dangdangduong2k2/Graduation_project/3d/images/electronics_case.png

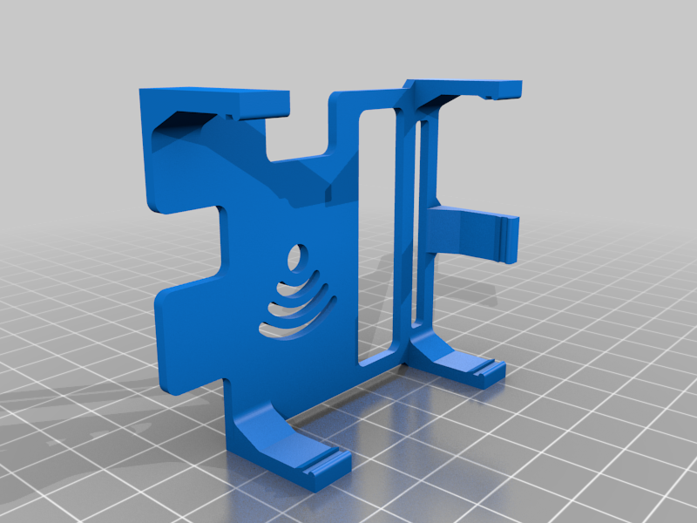
3d/images/electronics_case.png
