dangdangduong2k2/Graduation_project/3d/images/Modifiying-your-PyBot-Robotic-Arm.jpg

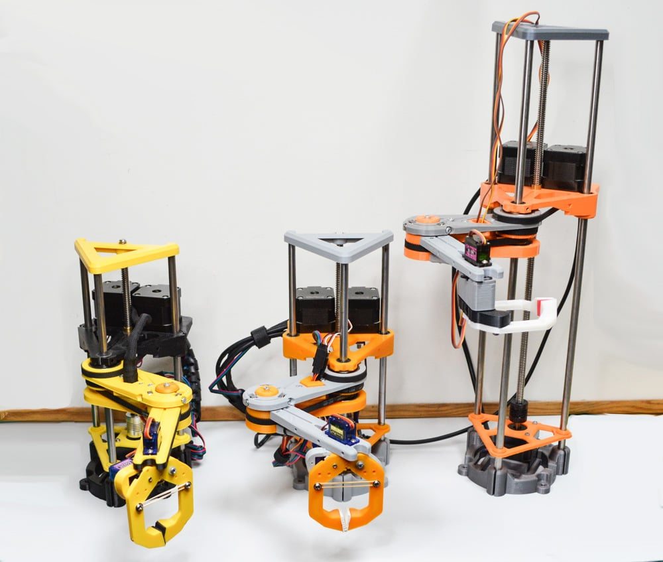
3d/images/Modifiying-your-PyBot-Robotic-Arm.jpg
