dangdangduong2k2/Graduation_project/3d/README.txt

Arduino Robotic Arm (OPEN SOURCE) + Python control APP + EXTRAS by jjrobots on Thingiverse: https://www.thingiverse.com/thing:4579405
