dangdangduong2k2/Graduation_project/0.HardWare_Unit/0.PCB/1.main/GiaCong/BOM/2024-12-17 BOM gpr.xlsx

Code | Code_sub1 | Comment | Description | Designator | LibRef | Layer | Footprint | SMT | Quantity | Price | LCSC Part | Reference Link | Erase IC | Note
 |  | DRV8825 |  | U2, U3, U5 | DRV8825 | Top | DRV8825 |  | 3
 |  | STM32F103C8T6 |  | U4 | STM32F103C8T6 | Top | LQFP-48_L7.0-W7.0-P0.50-LS9.0-BL |  | 1
 |  | XT60PW-M |  | CN1 | XT60PW-M | Top | CONN-TH_XT60PW-M |  | 1
1024-078 |  | 470R | Resistor SMD 0805 | R4, R7, R14 | Res 470R 0805 | Top | RES-SMD-0805 |  | 3
1024-094 |  | 2.2k | Resistor SMD 0805 | R1, R23, R26 | Res 2.2K 0805 | Top | RES-SMD-0805 |  | 3
1024-103 |  | 4.7K | Resistor SMD 0805 | R10, R11, R15, R21, R22, R25 | Res 4.7k 0805 | Top | RES-SMD-0805 |  | 6
1024-111 |  | 10K | Resistor SMD 0805 | R2, R5, R6, R8, R9, R16, R17, R29, R30, R31 | Res 10k 0805 | Top | RES-SMD-0805 |  | 10
1402-225 |  | 100uF/35V | Polarized Capacitor (Axial) 100uF 35V | C5, C11 | Cap Pol 100uF/35V | Top | C_6.3x12 |  | 2
1402-228 |  | 220uF/35V | Polarized Capacitor (Axial) 220uF 35V | C3 | Cap Pol 220uF/35V | Top | C8X12mm |  | 1
1436-100 |  | 10uF/25V | Cap SMD 0805 10uF | C8, C9 | Cap 0805 10uF 25V | Top | C_0805_SMD |  | 2
1438-080 |  | 104 | Cap SMD 0805 104-100nF-0.1uF 50V | C2, C4, C6, C7, C12, C14, C18, C19, C20, C21 | Cap 0805 104 100nF | Top | C_0805_SMD |  | 10
1522-003 |  | 68uH | CDRH127 Cuộn Cảm Dán SMD 1280-680 68uH 3.2A | L1 | IND CDRH127 1280-680 68uH | Top | CDRH127 |  | 1
2005-008 |  | SS34 | Surface-Mount Schottky Barrier Rectifier | D1, D2, D3, D5 | SS34-SMA | Top | D_SMA |  | 4
3504-028 * 0.1 |  | HDR-M-4P | HDR 2.54 MALE | P3 | HDR 2.54 M 4 Pin | Top | HDR_M_1X4 |  | 1
3509-010 |  | XH2.54 2P | XH2.54 RA | P8, P9, P10 | XH2.54_2P_RA | Top | XH2.54_2P_RA |  | 3
3509-011 |  | XH2.54 3P | XH2.54 RA | P11 | XH2.54_3P_RA | Top | XH2.54_3P_RA |  | 1
3509-012 |  | XH2.54 4P | XH2.54 RA | P1, P2, P4, P5, P6, P7 | XH2.54_4P_RA | Top | XH2.54_4P_RA |  | 6
3606-006 |  | SW-SMD | Button 3x6 mm x 2.5mm 2Pin SMD | S1, S2, S3, S4 | SW2 SMD 3x6 | Top | SW-SMD 3x6 mm |  | 4
5101-052 |  | LM2596HVS-5.0 | Vin 4.5-40VDC, Vout 5VDC, Iout MAX 3A | U1 | LM2596HVS-5.0 | Top | TO-263-5 |  | 1
5102-034 |  | AMS1117 | SOT-223 | IC1 | AMS1117-3.3V SOT223 | Top | SOT223-4N |  | 1
8600-017 |  | LED RED | LED 0805 SMD RED | 24V | LED 0805 RED | Top | LED 0805 Red |  | 1
8600-019 |  | LED BLUE | LED 0805 SMD BLUE | 3.3V | LED 0805 BLUE | Top | LED 0805 Blue |  | 1
8600-027 |  | LED GREEN | LED 0805 SMD GREEN | S1, S2 | LED 0805 GREEN | Top | LED 0805 Green |  | 2
1024-054 |  | 47R | Resistor SMD 0805 | R12, R13, R18, R19, R20, R24, R27, R28 | Res 47R 0805 | Top | RES-SMD-0805 |  | 8
2006-041 |  | SMAJ24A | SMAJ Series 400W Surface Mount Uni-Directional TVS Diode - DO-214AC | D4, D6 | TVS SMAJ24A-DO241AC | Top | DO_241AC_SMA_MFG |  | 2
1402-231 |  | 470uF/35V | Polarized Capacitor (Axial) 470uF 35V | C1, C10, C17, C22 | Cap Pol 470uF/35V | Top, Bottom | C8X12mm |  | 4
