dangdangduong2k2/Graduation_project/3d/files/TOP_TRIANGLE_[V10.stl

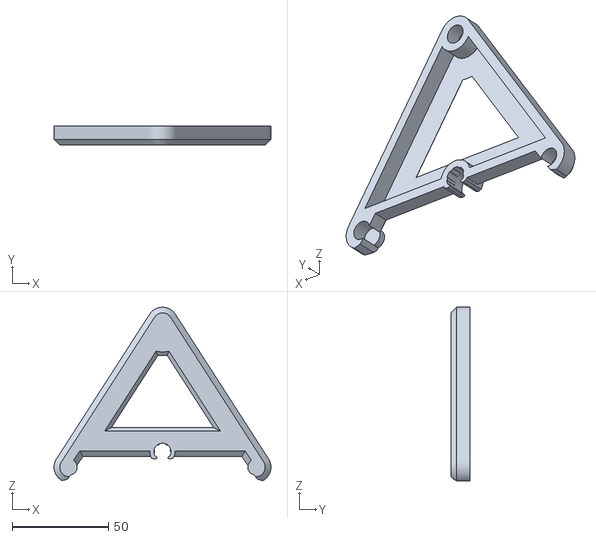
[picture p3: CAD file, 2025-01-12]
3d/files/TOP_TRIANGLE_[V10.stl
112.6 x 10.0 x 90.1
