dangdangduong2k2/Graduation_project/3d/stepfiles/banhrangkhau3.step

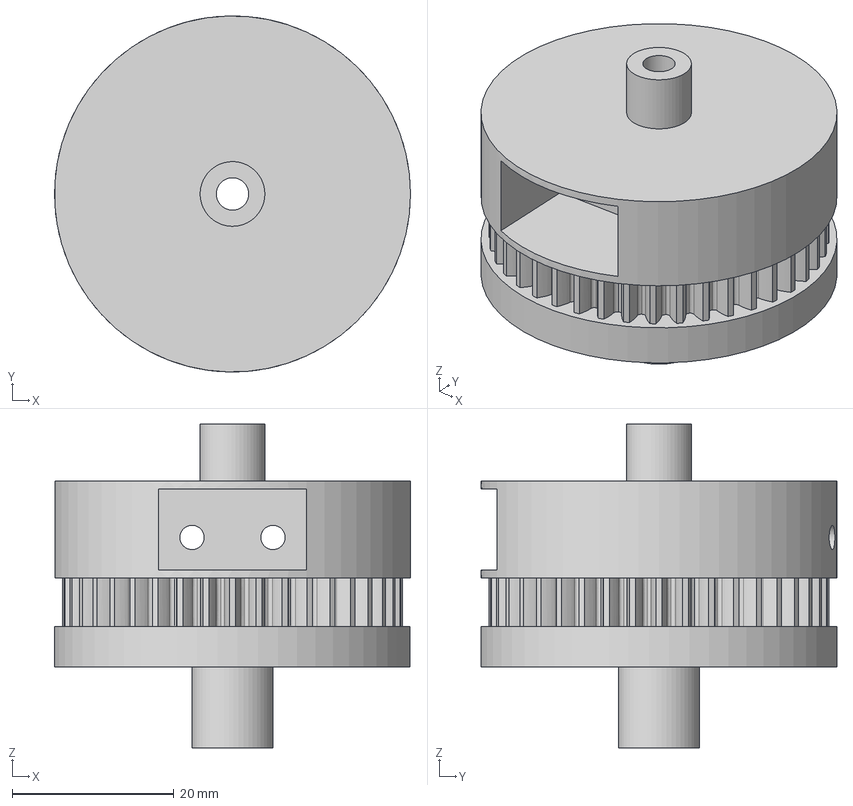
[picture p4: CAD file, 2025-01-12]
3d/stepfiles/banhrangkhau3.step
44.0 x 44.0 x 40.0 mm
