dangdangduong2k2/Graduation_project/3d/files/ARM_HUB_[V11.stl

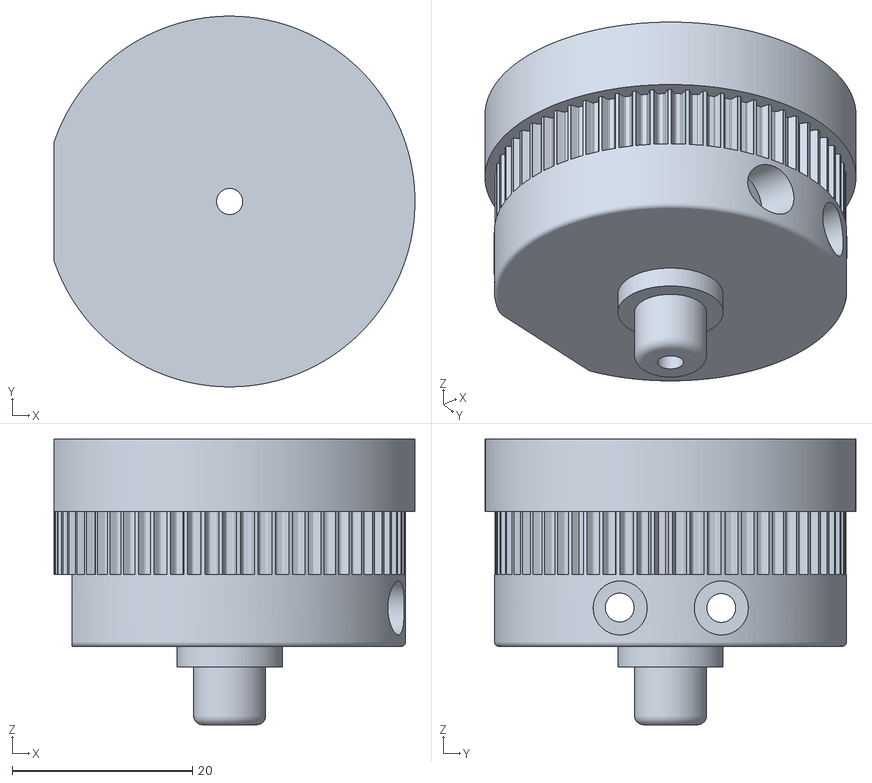
[picture p5: CAD file, 2025-01-12]
3d/files/ARM_HUB_[V11.stl
40.1 x 41.2 x 31.7
