dangdangduong2k2/Graduation_project/3d/files/ARM_BOTTOM_[V10.stl

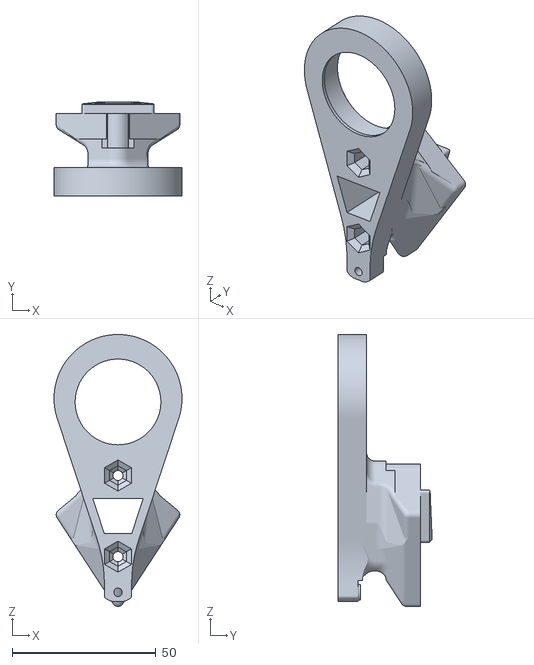
[picture p6: CAD file, 2025-01-12]
3d/files/ARM_BOTTOM_[V10.stl
44.5 x 32.8 x 94.6
