dangdangduong2k2/Graduation_project/3d/stepfiles/khau2.step

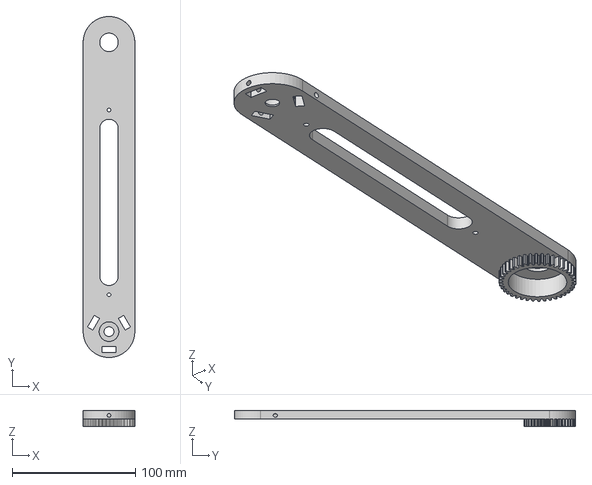
[picture p7: CAD file, 2025-01-12]
3d/stepfiles/khau2.step
42.0 x 277.0 x 13.0 mm
