dangdangduong2k2/Graduation_project/3d/files/PEN_HOLDER_[V10.stl

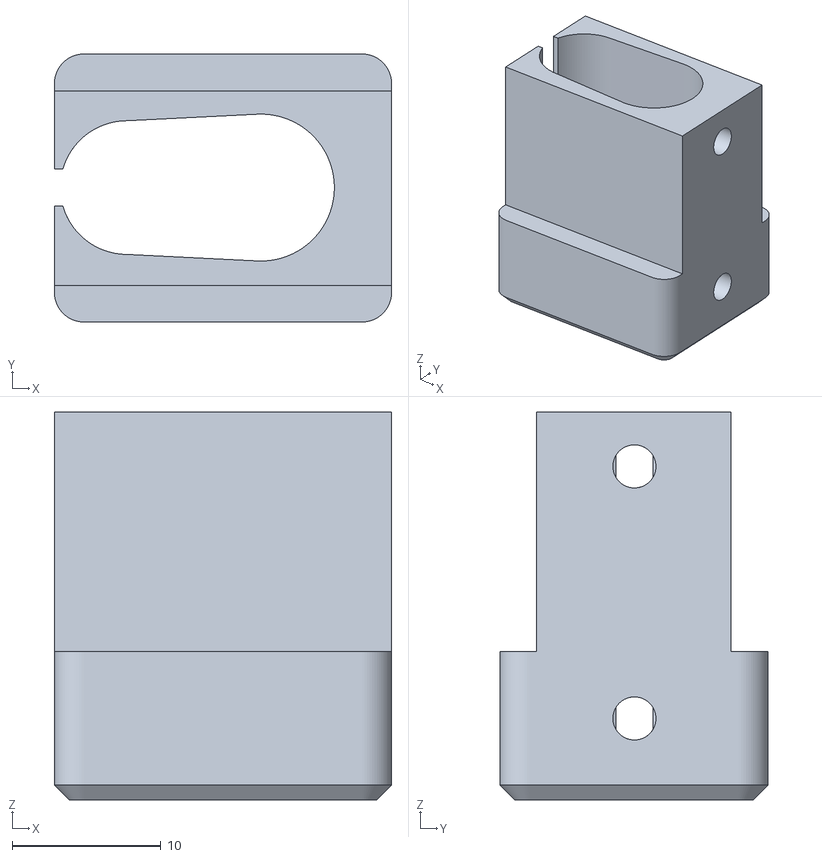
[picture p8: CAD file, 2025-01-12]
3d/files/PEN_HOLDER_[V10.stl
22.7 x 18.0 x 26.1
