dangdangduong2k2/Graduation_project/3d/stepfiles/tido.step

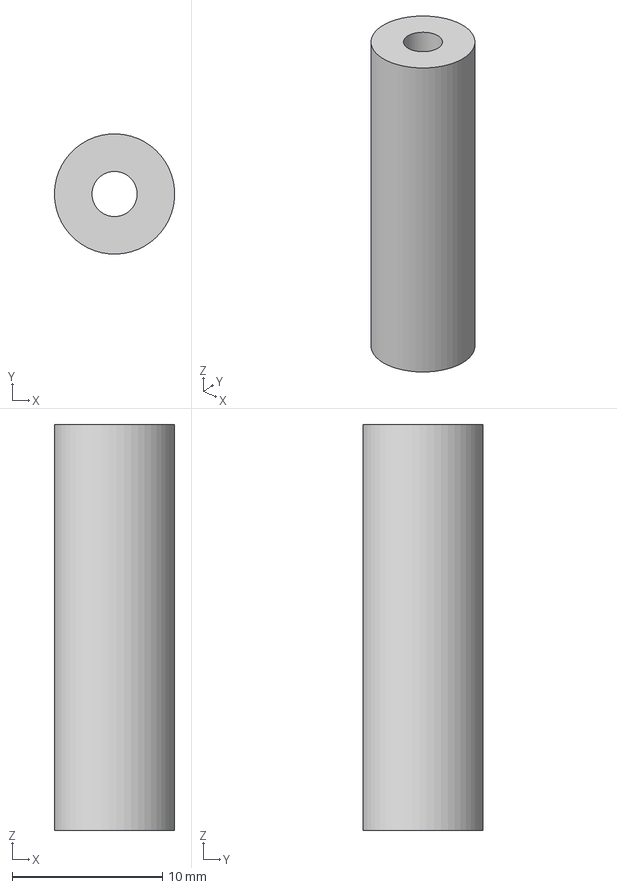
[picture p9: CAD file, 2025-01-12]
3d/stepfiles/tido.step
7.99 x 8.00 x 27.0 mm
