dangdangduong2k2/Graduation_project/3d/files/CABLES_CAP_[V10.stl

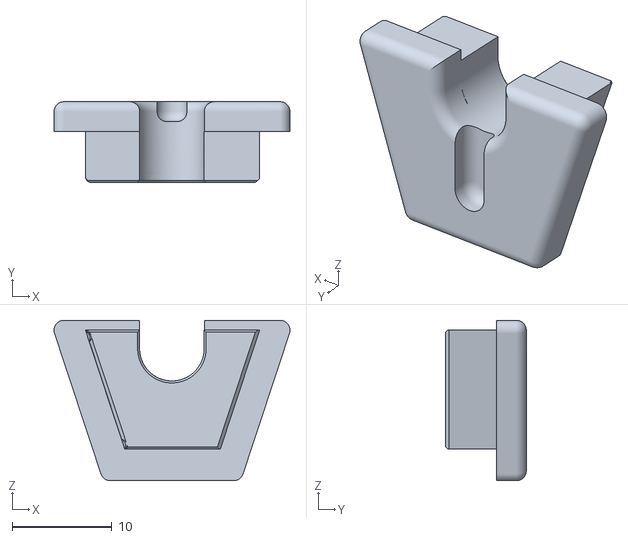
[picture p10: CAD file, 2025-01-12]
3d/files/CABLES_CAP_[V10.stl
23.7 x 8.10 x 16.1
