dangdangduong2k2/Graduation_project/3d/stepfiles/giubanhrangkhau3.step

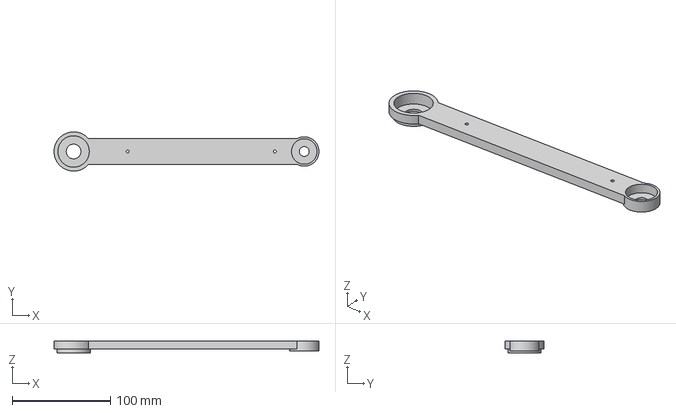
[picture p11: CAD file, 2025-01-12]
3d/stepfiles/giubanhrangkhau3.step
270.0 x 40.0 x 12.0 mm
