dangdangduong2k2/Graduation_project/3d/files/FOREAM_[V10.stl

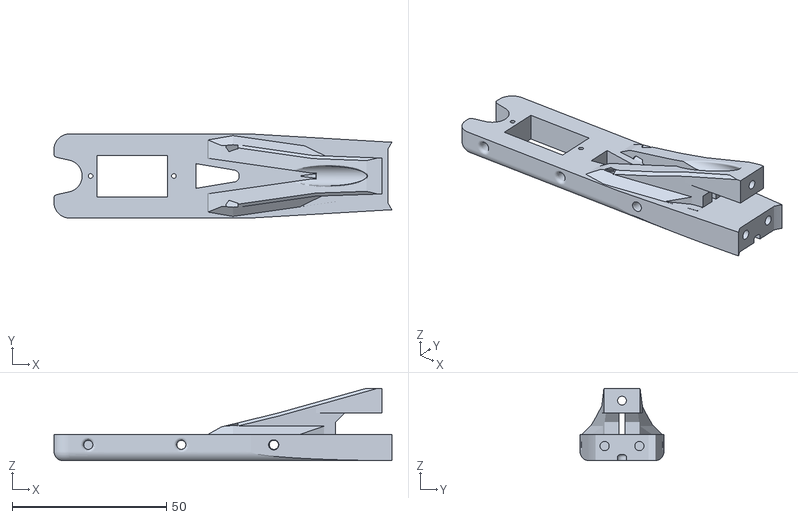
[picture p12: CAD file, 2025-01-12]
3d/files/FOREAM_[V10.stl
109.6 x 27.2 x 23.5
