dangdangduong2k2/Graduation_project/3d/stepfiles/banhrangkhau2.step

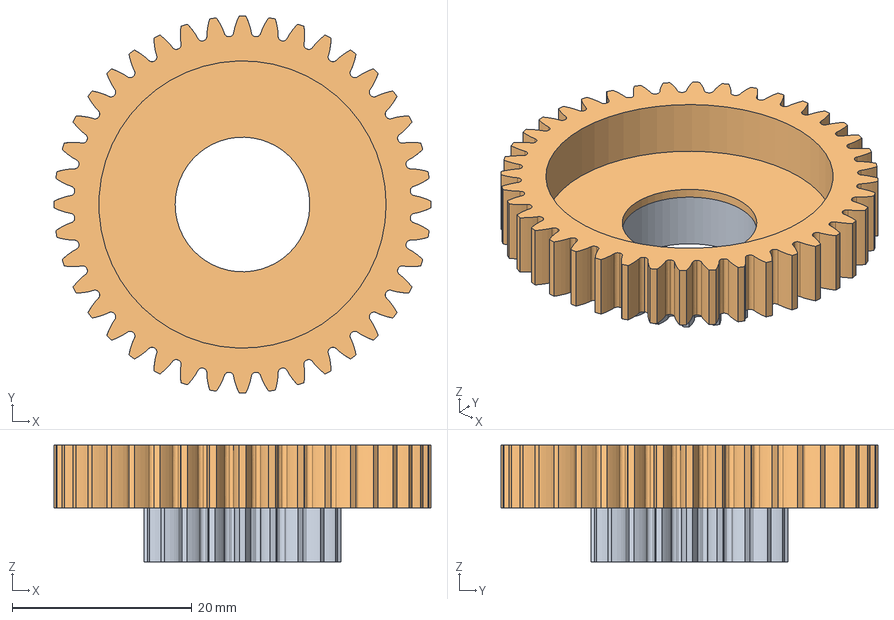
[picture p13: CAD file, 2025-01-12]
3d/stepfiles/banhrangkhau2.step
42.0 x 42.0 x 13.0 mm
Spur Gear (20 teeth)
Spur Gear (40 teeth)
