dangdangduong2k2/Graduation_project/3d/files/electronics_case.stl

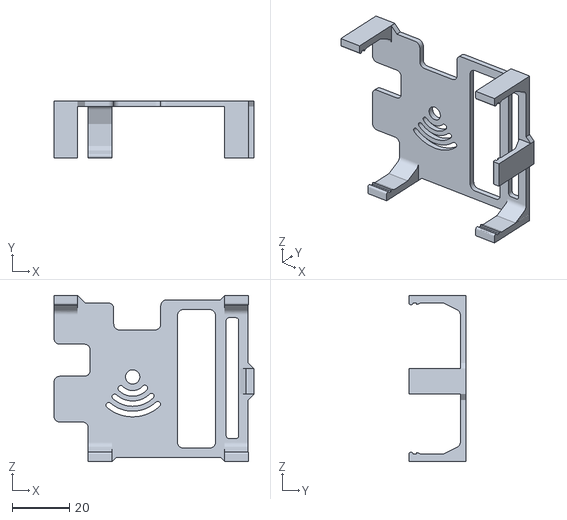
[picture p14: CAD file, 2025-01-12]
3d/files/electronics_case.stl
70.1 x 20.0 x 58.2
