dangdangduong2k2/Graduation_project/3d/files/CAP_[V10.stl

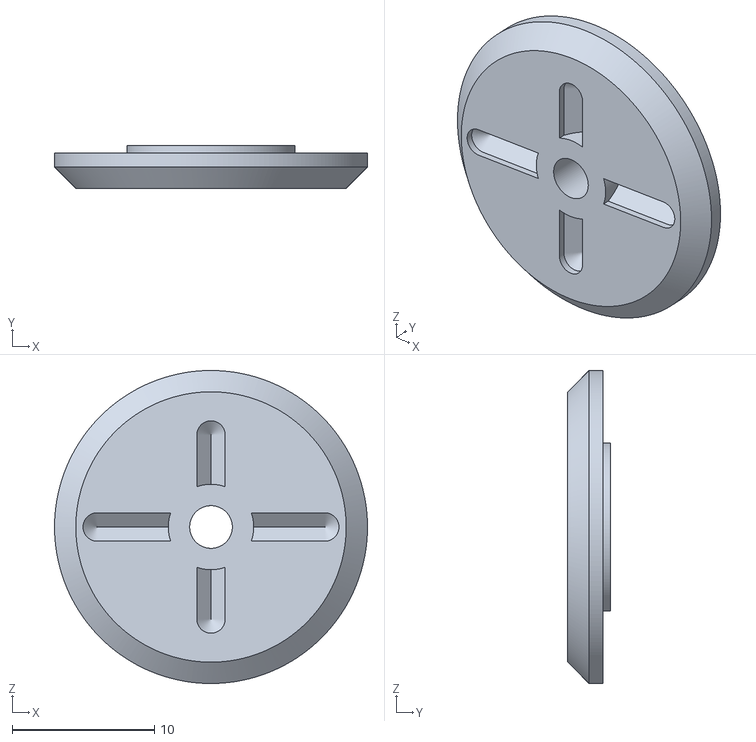
[picture p15: CAD file, 2025-01-12]
3d/files/CAP_[V10.stl
22.0 x 3.00 x 22.0
