dangdangduong2k2/Graduation_project/3d/files/BASEPLATE_[V10.stl

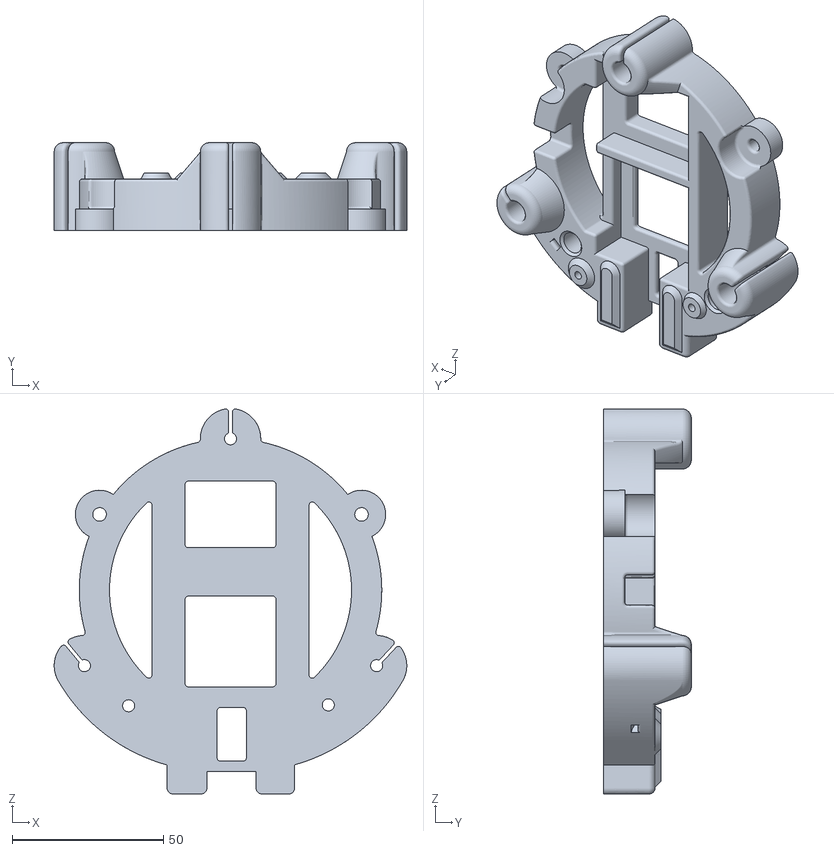
[picture p16: CAD file, 2025-01-12]
3d/files/BASEPLATE_[V10.stl
116.6 x 29.0 x 127.3
