dangdangduong2k2/Graduation_project/3d/files/Z_BASE_[V10.stl

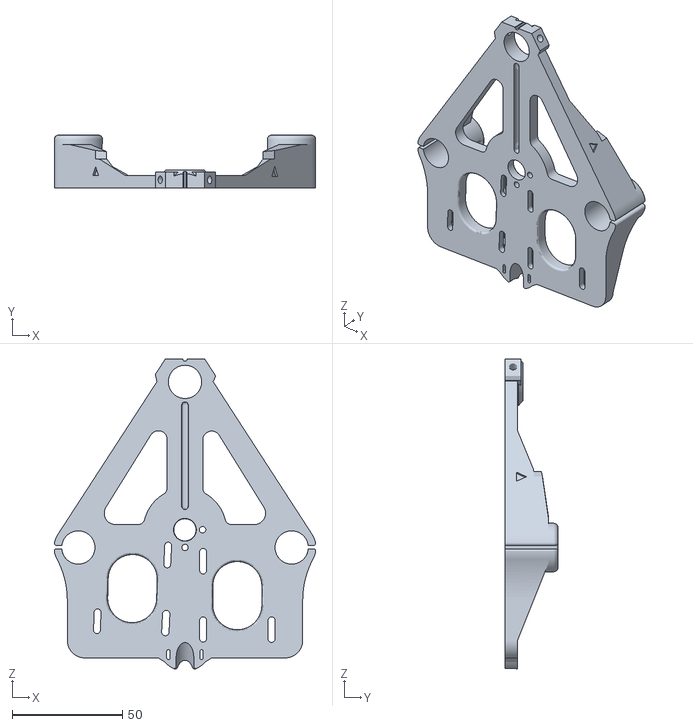
[picture p17: CAD file, 2025-01-12]
3d/files/Z_BASE_[V10.stl
118.4 x 24.0 x 140.4
