dangdangduong2k2/Graduation_project/3d/files/REDUCTION_[V10.stl

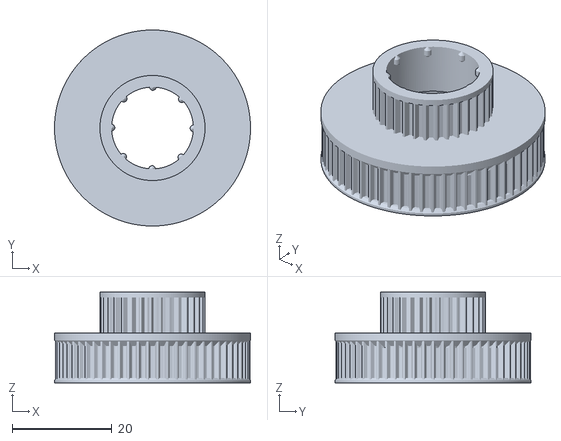
[picture p18: CAD file, 2025-01-12]
3d/files/REDUCTION_[V10.stl
39.3 x 39.3 x 18.2
