dangdangduong2k2/Graduation_project/3d/files/MOTORS_TRIANGLE_[V10.stl

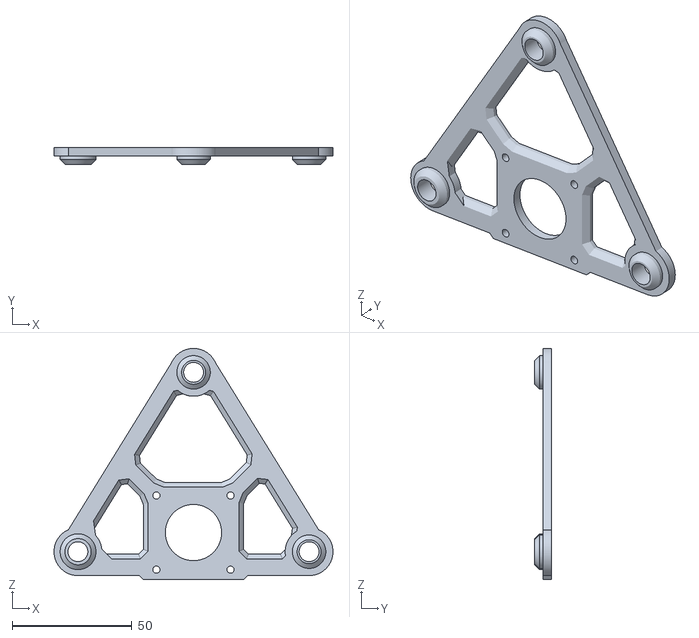
[picture p19: CAD file, 2025-01-12]
3d/files/MOTORS_TRIANGLE_[V10.stl
116.7 x 7.00 x 96.7
