dangdangduong2k2/Graduation_project/3d/files/GRIPPER-_NAILS_[V10.stl

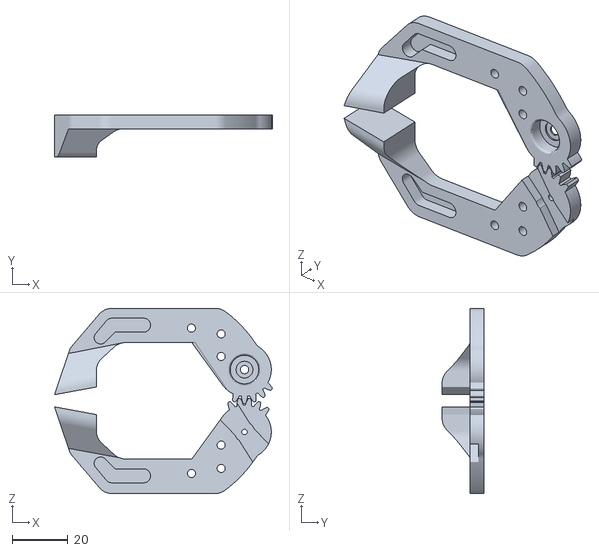
[picture p20: CAD file, 2025-01-12]
3d/files/GRIPPER-_NAILS_[V10.stl
78.0 x 15.0 x 66.3
