dangdangduong2k2/Graduation_project/3d/files/GRIPPER-_BASE_[V10.stl

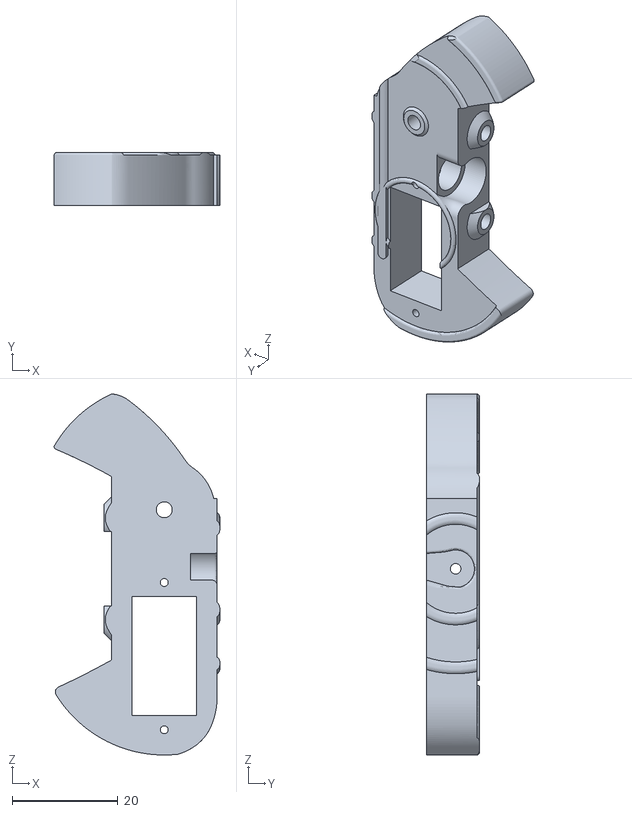
[picture p21: CAD file, 2025-01-12]
3d/files/GRIPPER-_BASE_[V10.stl
31.3 x 10.0 x 68.2
