dangdangduong2k2/Graduation_project/3d/files/LEFT_and_RIGHT_nails_SEPARATED_V3.stl

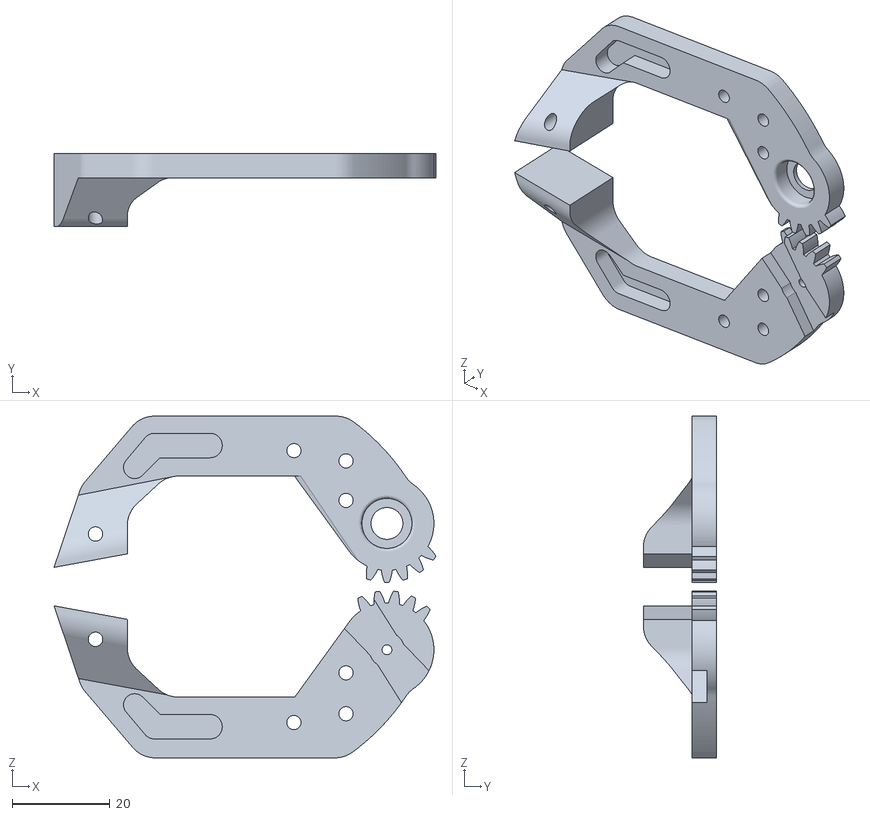
[picture p22: CAD file, 2025-01-12]
3d/files/LEFT_and_RIGHT_nails_SEPARATED_V3.stl
78.0 x 15.0 x 69.8
