dangdangduong2k2/Graduation_project/3d/files/ARM_TOP_[V9.stl

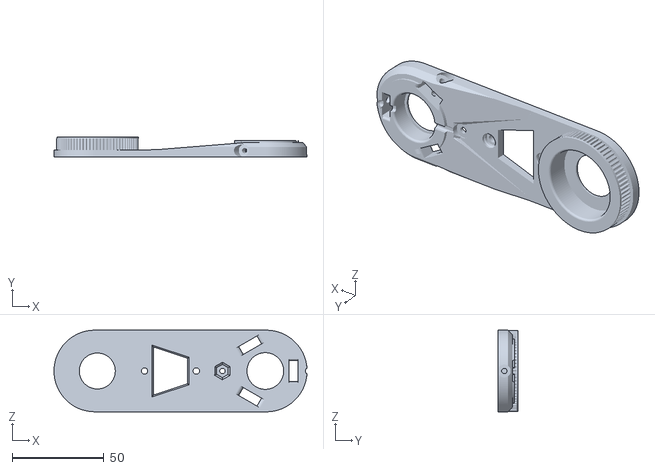
[picture p23: CAD file, 2025-01-12]
3d/files/ARM_TOP_[V9.stl
137.9 x 11.0 x 44.5
