dangdangduong2k2/Graduation_project/(list of files, cad)

Other CAD files:
0.HardWare_Unit/0.PCB/0.chess board/GiaCong/schematic.dwg
3d/stepfiles/khau3.step
