dangdangduong2k2/Graduation_project/0.HardWare_Unit/0.PCB/0.chess board/GiaCong/Local/Schematic_2025-01-07_chessboard.PDF

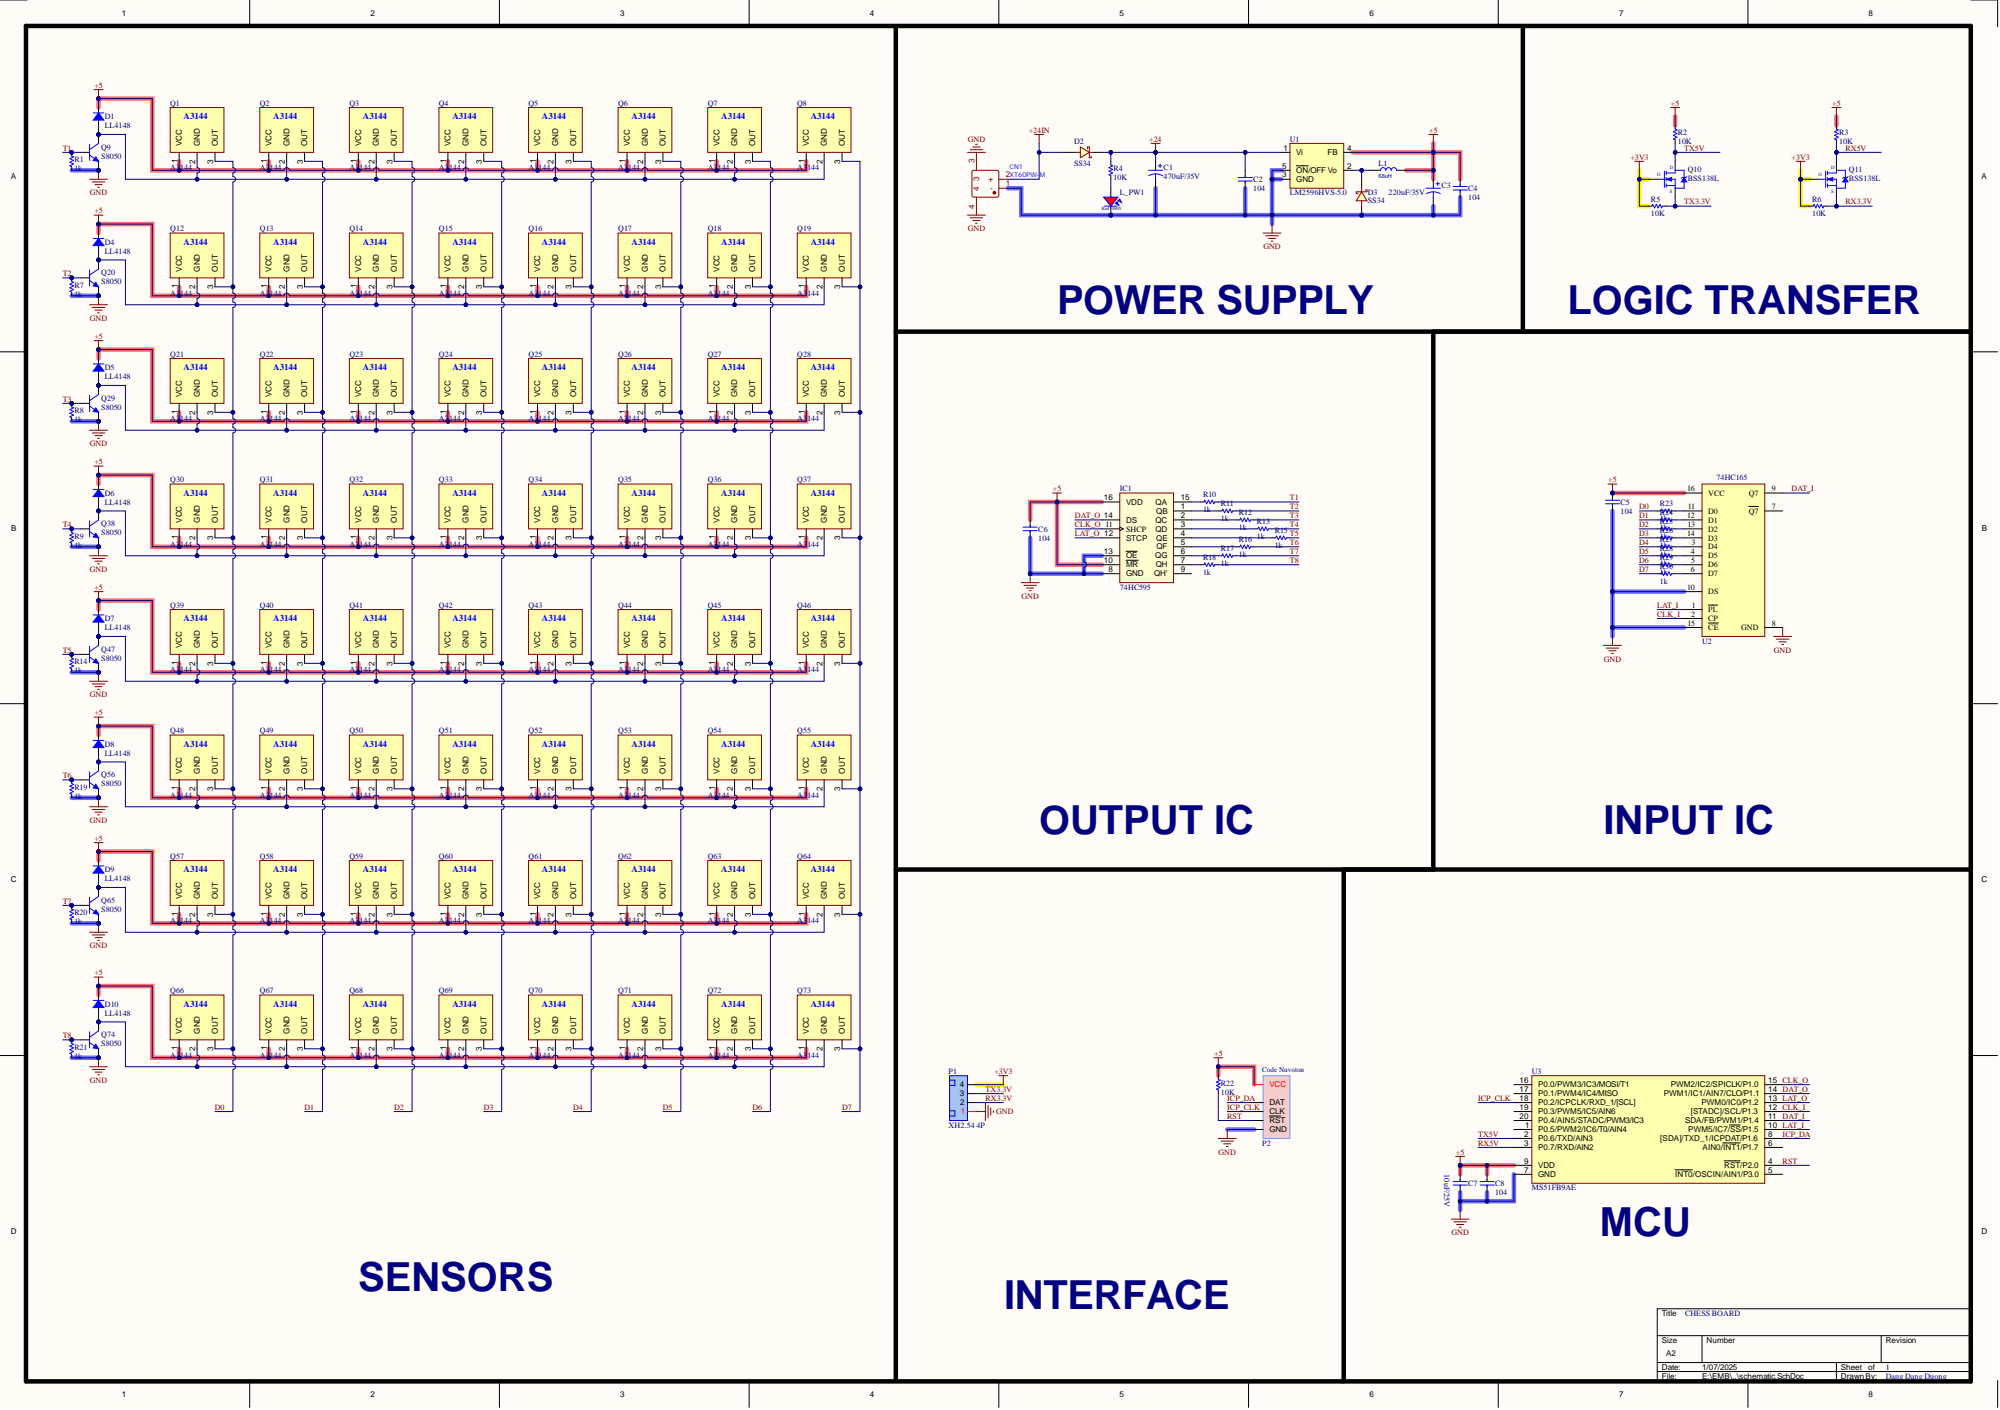
[picture p24: page 1]

D 0 | D 1 | SENSORS | D 2 | D 3 | D 4 | D 5 | D 6

Siz e | Numbe r | Revis i o n

: 1/07/20 2 5 | Sheet of 1
File : E: \EMB\ . . \ s chem a t i c . S c h D o c | Drawn By : Dan g Dan g D u o n g
