dangdangduong2k2/Graduation_project/0.HardWare_Unit/0.PCB/0.chess board/GiaCong/chessboard/Schematic_2024-12-22_chessboard.PDF

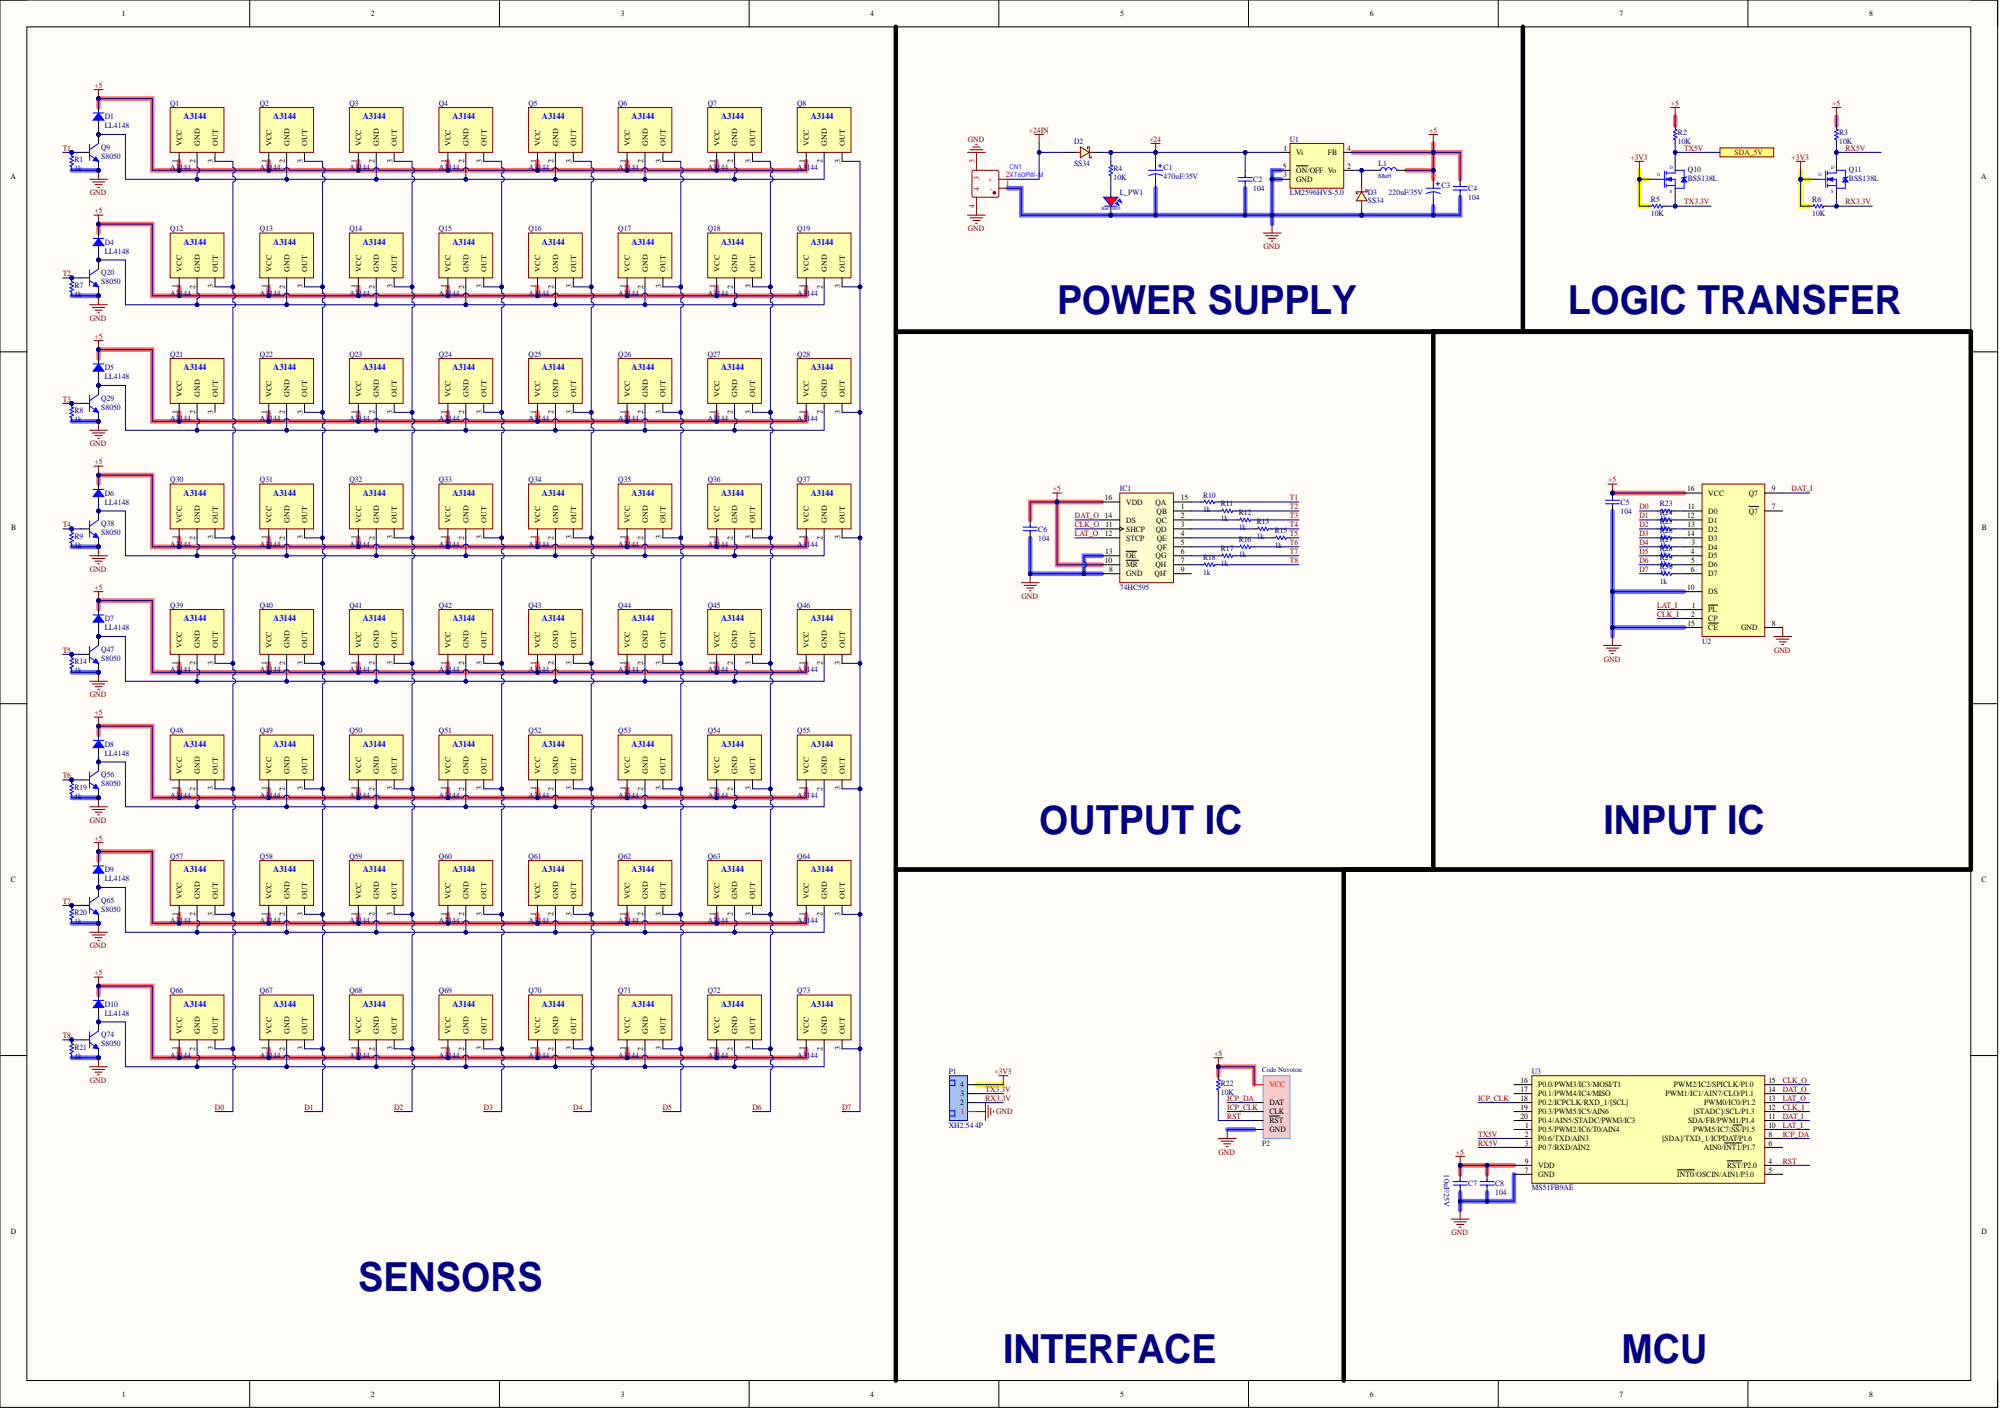
[picture p25: page 1]
