dangdangduong2k2/Graduation_project/0.HardWare_Unit/0.PCB/0.chess board/GiaCong/Local/Schematic_2024-12-31_chessboard.PDF

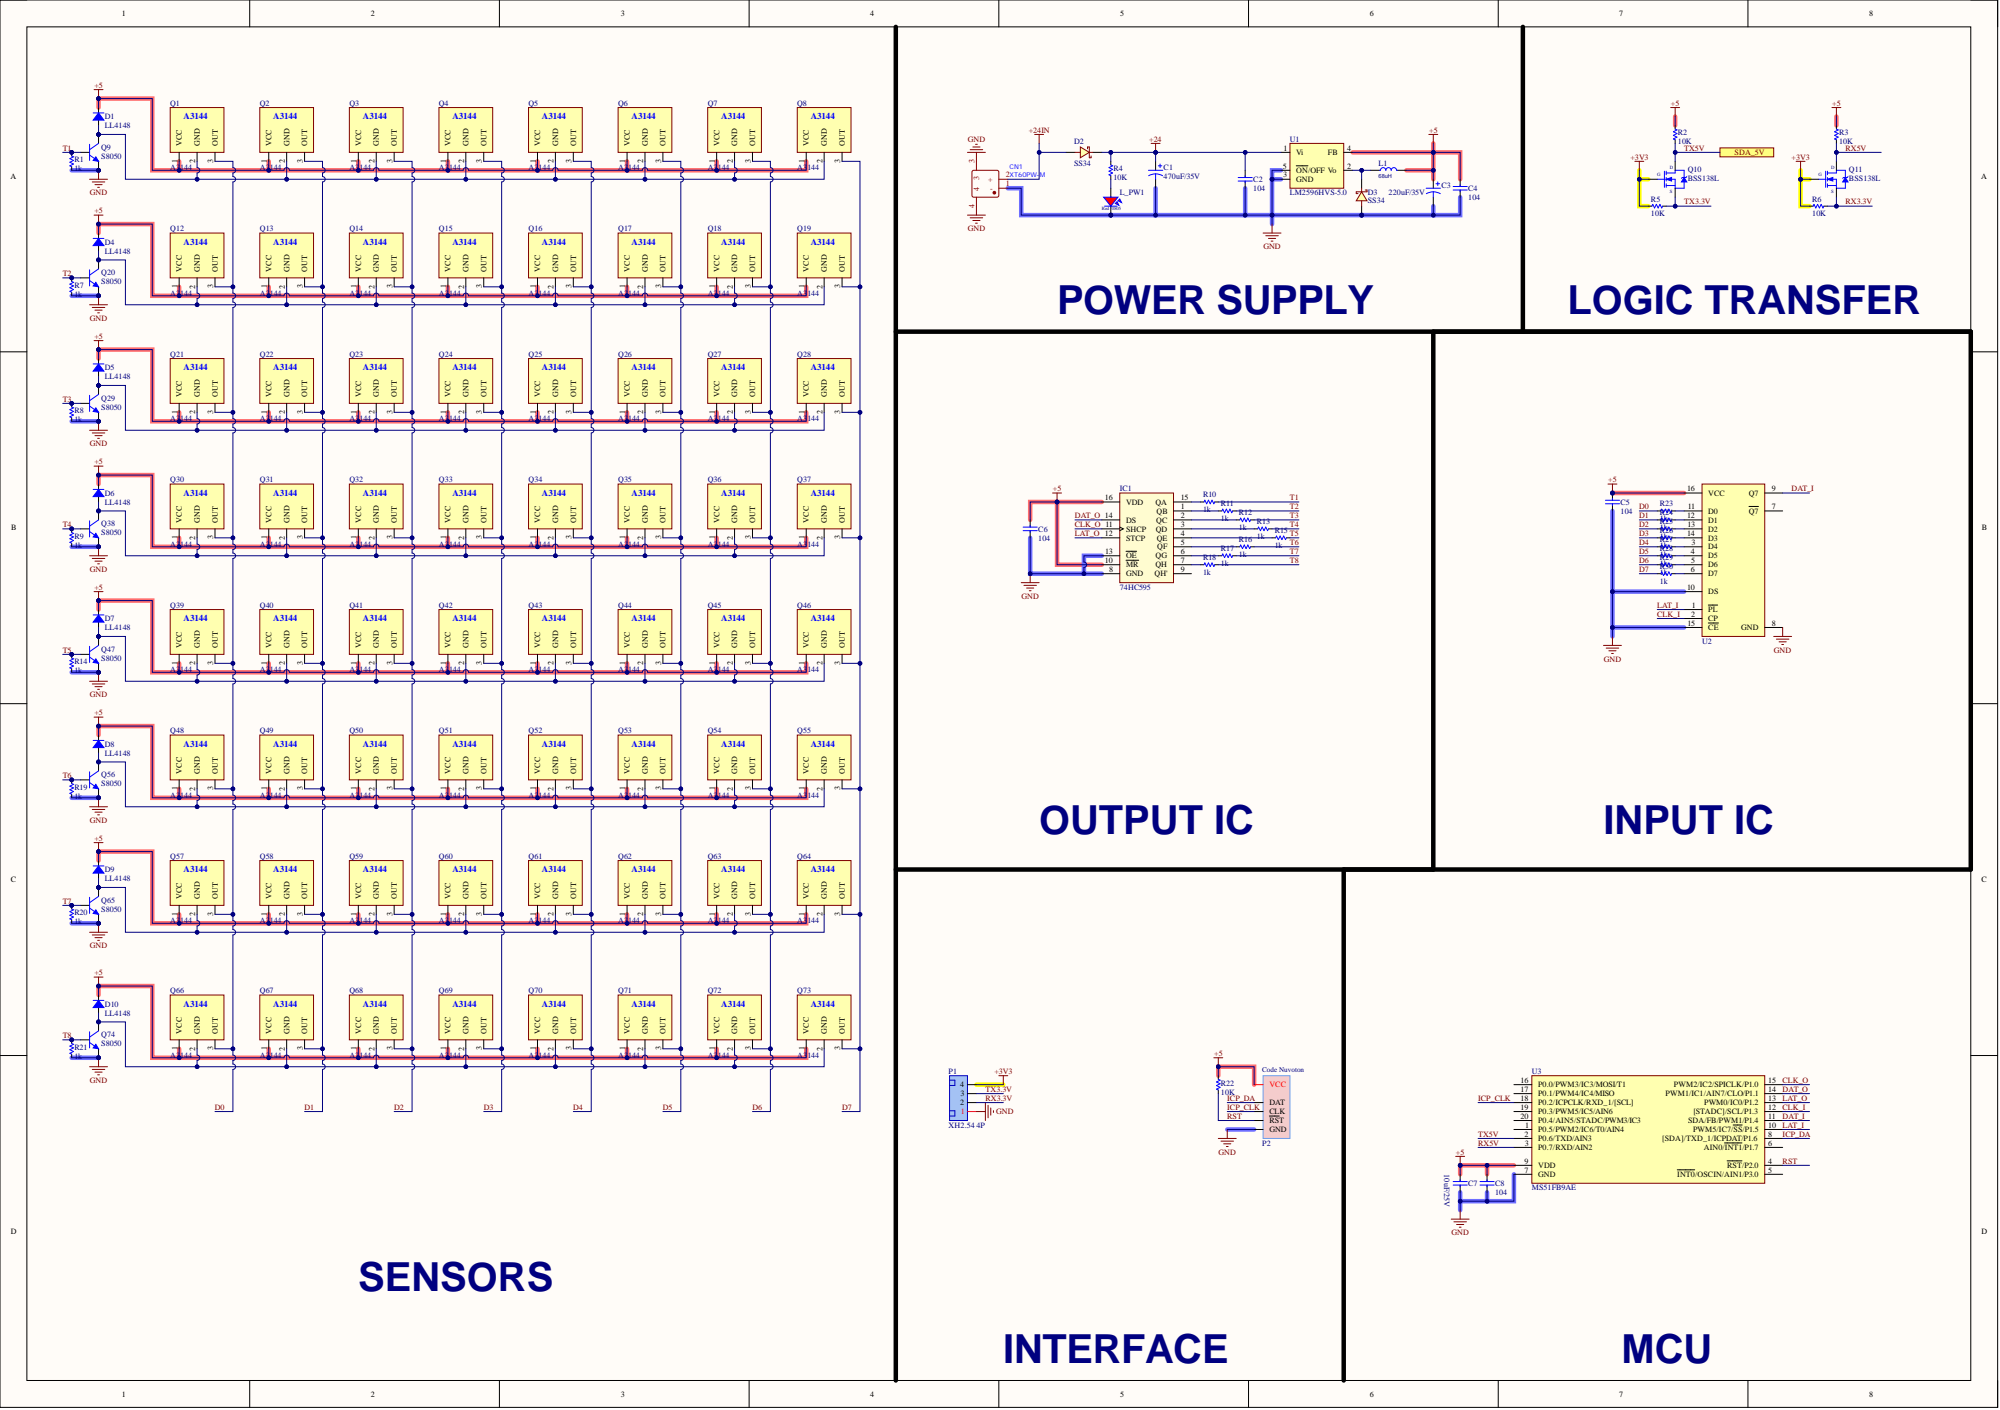
[picture p26: page 1]
