dangdangduong2k2/Graduation_project/0.HardWare_Unit/0.PCB/1.main/GiaCong/Local/Schematic_2025-01-04_gpr.PDF

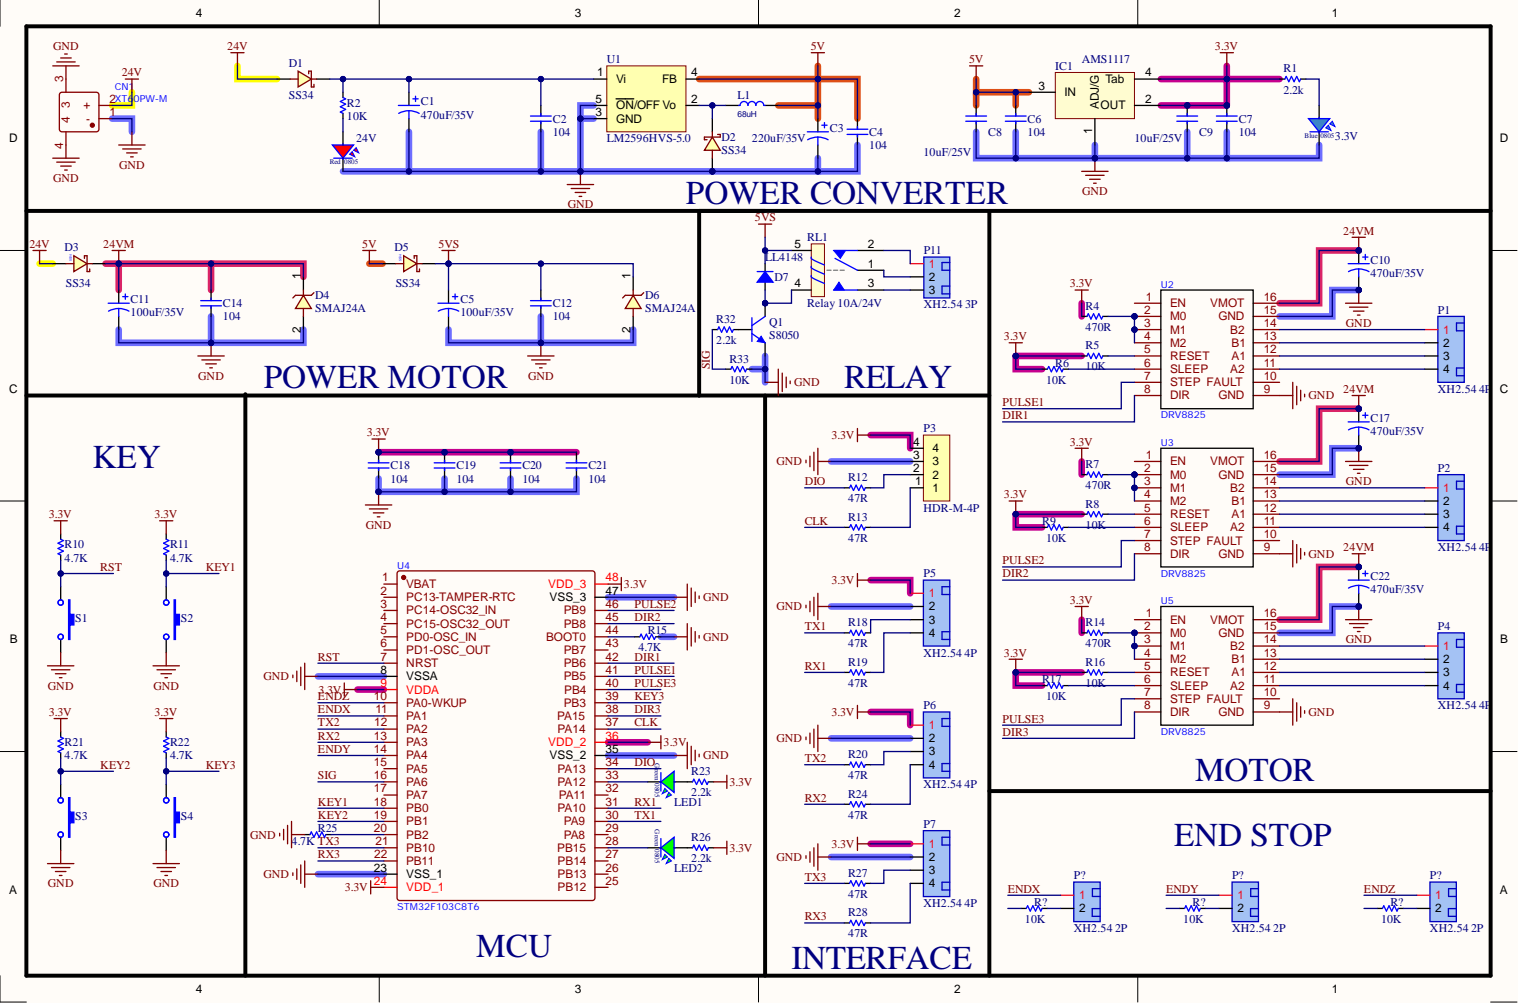
[picture p27: page 1]
