dangdangduong2k2/Graduation_project/0.HardWare_Unit/0.PCB/1.main/GiaCong/Local/Schematic_2025-01-07_gpr.PDF

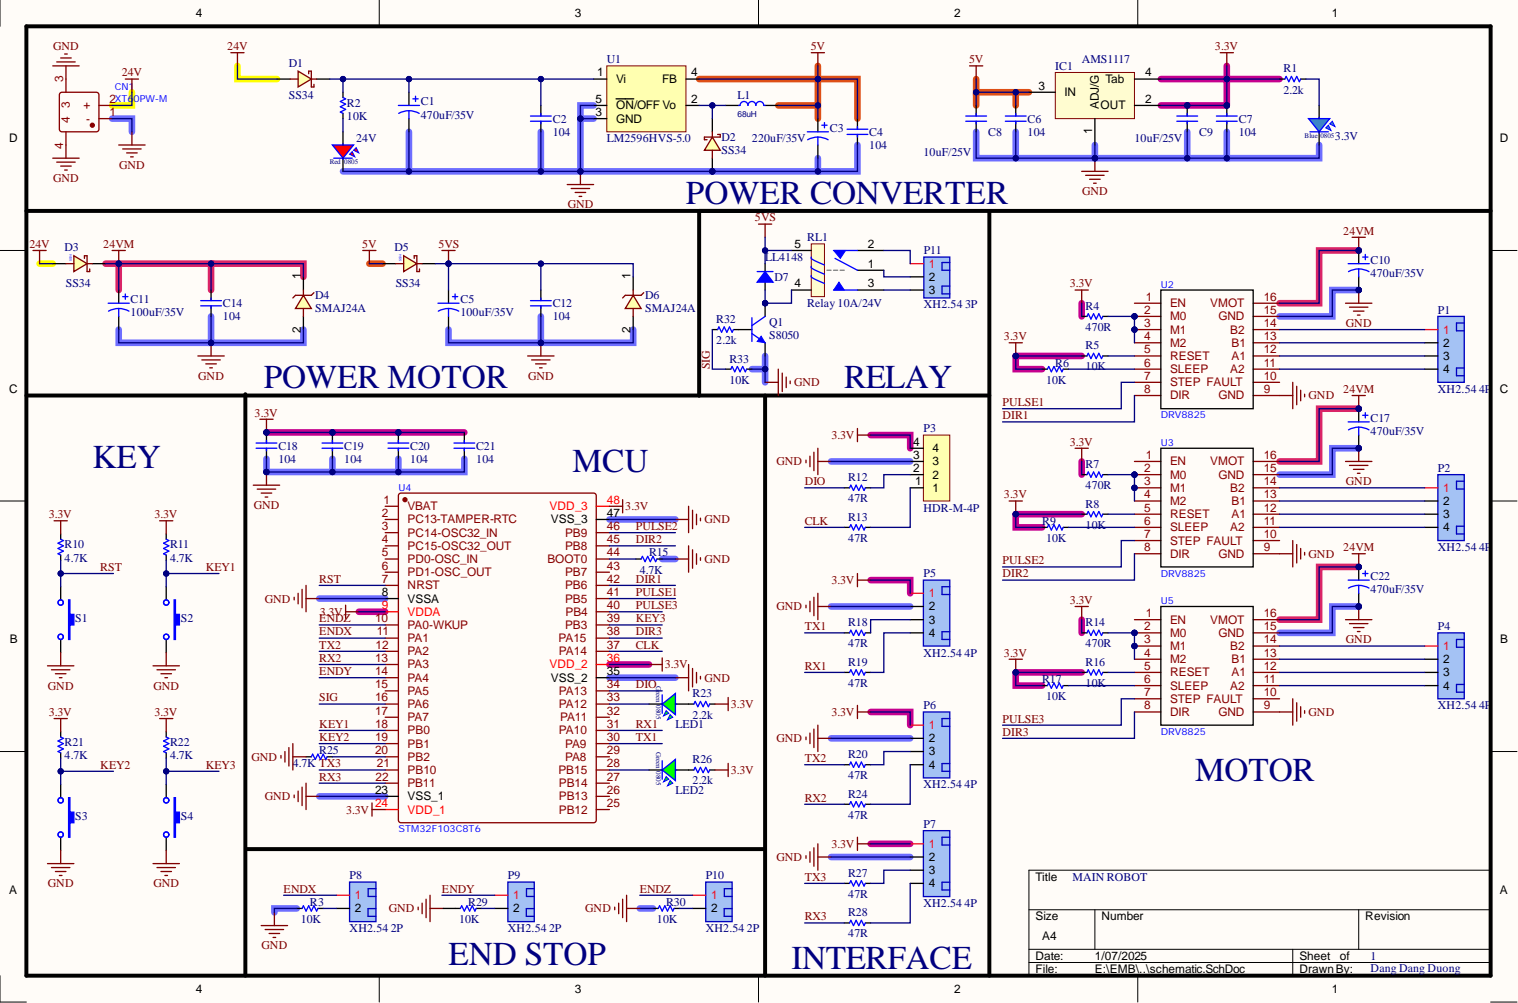
[picture p28: page 1]

Siz e | Numbe r | Revis i o n

: 1/07/20 2 5 | Sheet of 1Dan
File : E: \EMB\ . . \ s chem a t i c . S c h D o c | Drawn By : g Dan g D u o n g
