dangdangduong2k2/Graduation_project/0.HardWare_Unit/0.PCB/1.main/GiaCong/Local/Schematic_2025-01-10_gpr.PDF

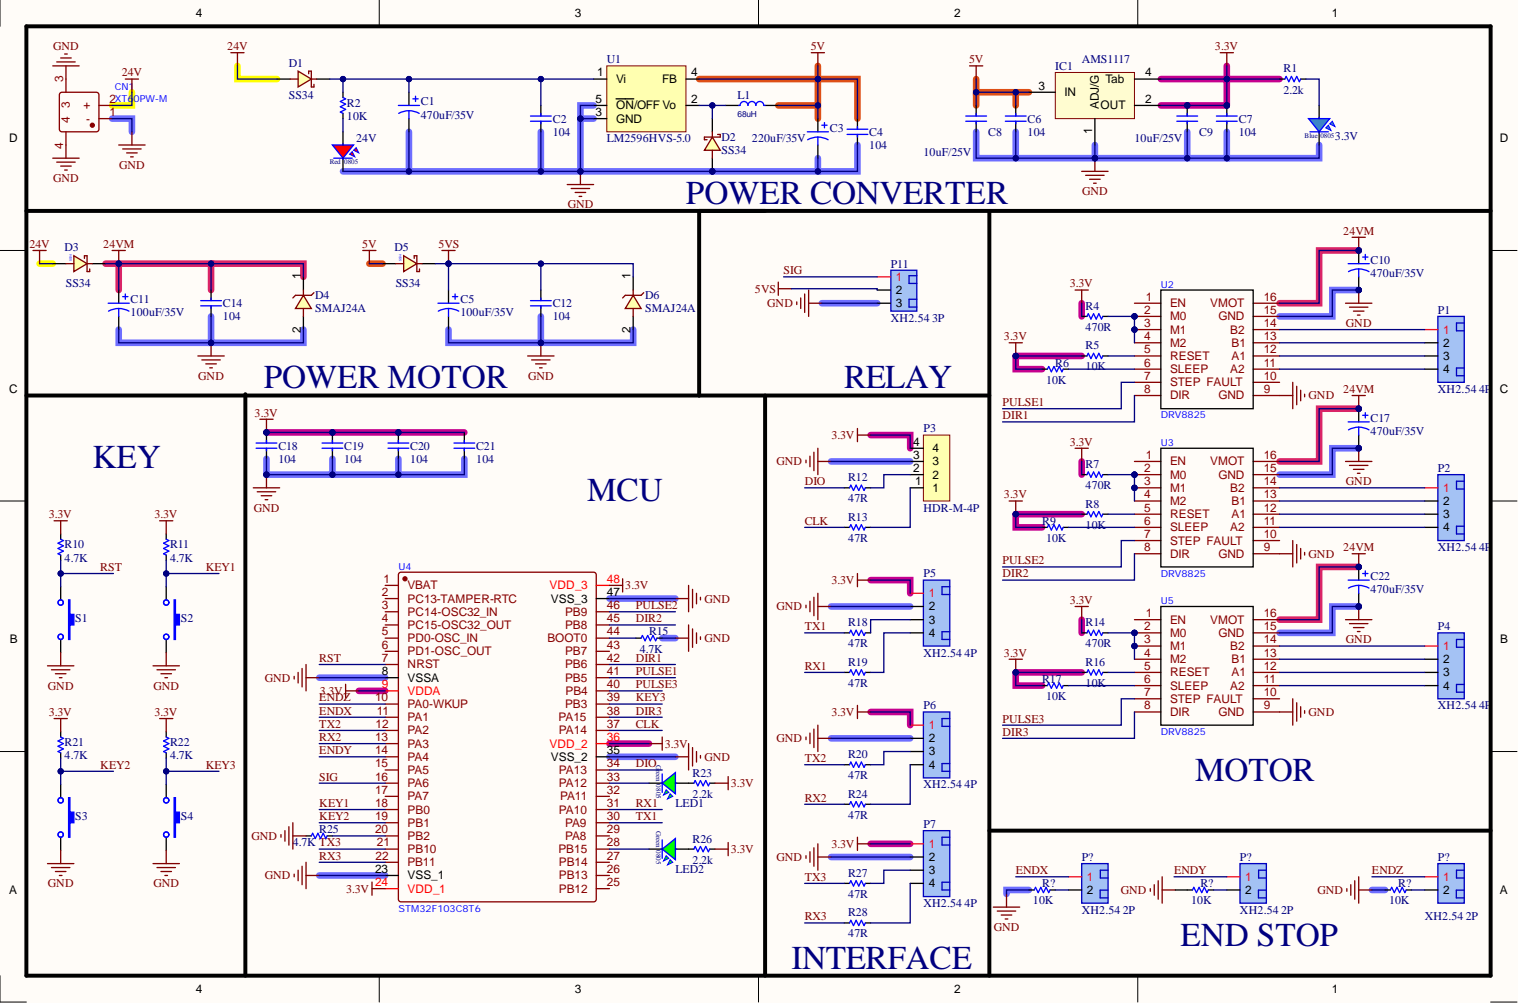
[picture p29: page 1]
