dangdangduong2k2/Graduation_project/0.HardWare_Unit/0.PCB/1.main/GiaCong/main/Schematic_2024-12-22_gpr.PDF

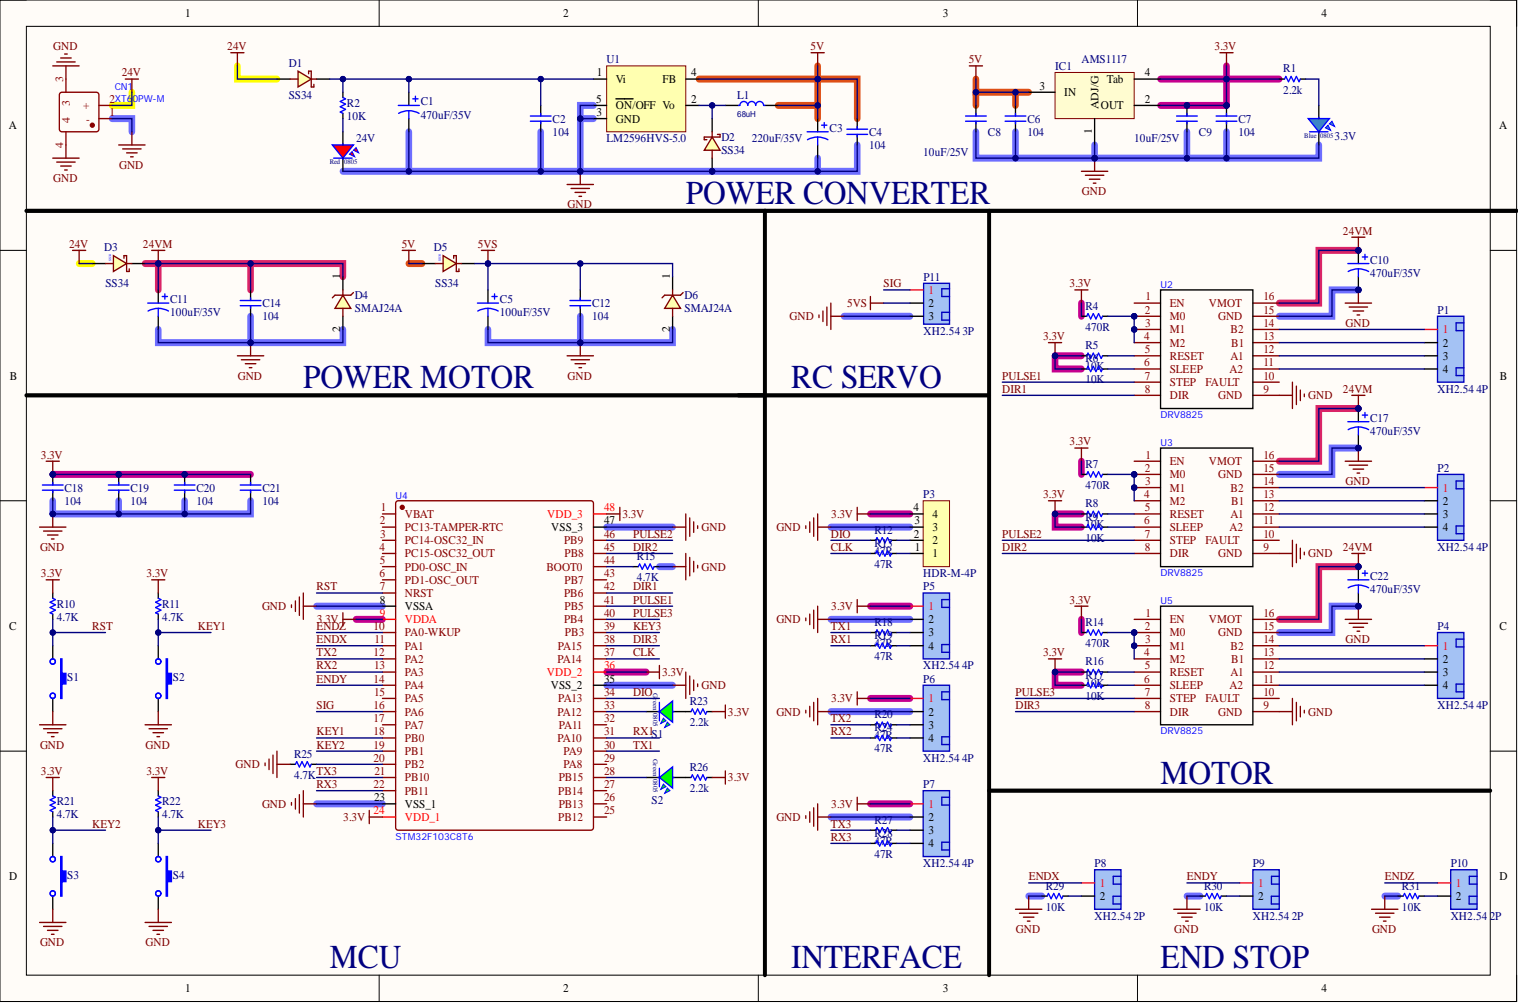
[picture p30: page 1]

3 | G N | P2XH 2134
4 | 13 B2 14 2 B1
