dangdangduong2k2/Graduation_project/3d/banve/250110 - BVKT - De Robot - TCVN 7284.pdf

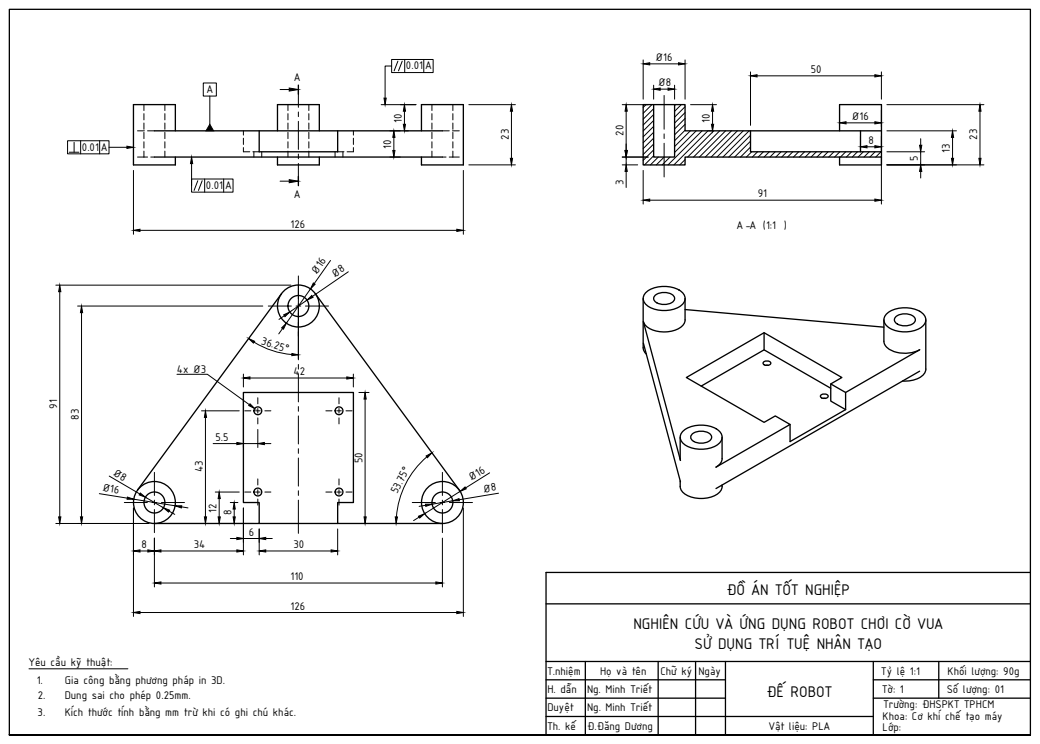
[picture p31: page 1]
T.nhiệm; Đ.Đăng Dương; Chữ ký; Ngày; Khối lượng: 90g; Số lượng: 01; ĐẾ ROBOT; Kích thước tính bằng mm trừ khi có ghi chú khác.; Ng. Minh Triết

ĐỒ ÁN TỐT NGHIỆP

NGHIÊN CỨU VÀ ỨNG DỤNG ROBOT CHƠI CỜ VUA
SỬ DỤNG TRÍ TUỆ NHÂN TẠO

Yêu cầu kỹ thuật:
1. Gia công bằng phương pháp in 3D.
2. Dung sai cho phép 0.25mm.

Họ và tên

H. dẫn | Ng. Minh Triết
Duyệt

Trường: ĐHSPKT TPHCM
Khoa: Cơ khí chế tạo máy
Lớp:

Vật liệu: PLA
