dangdangduong2k2/Graduation_project/banve/banvedien/machbanco-Model.pdf

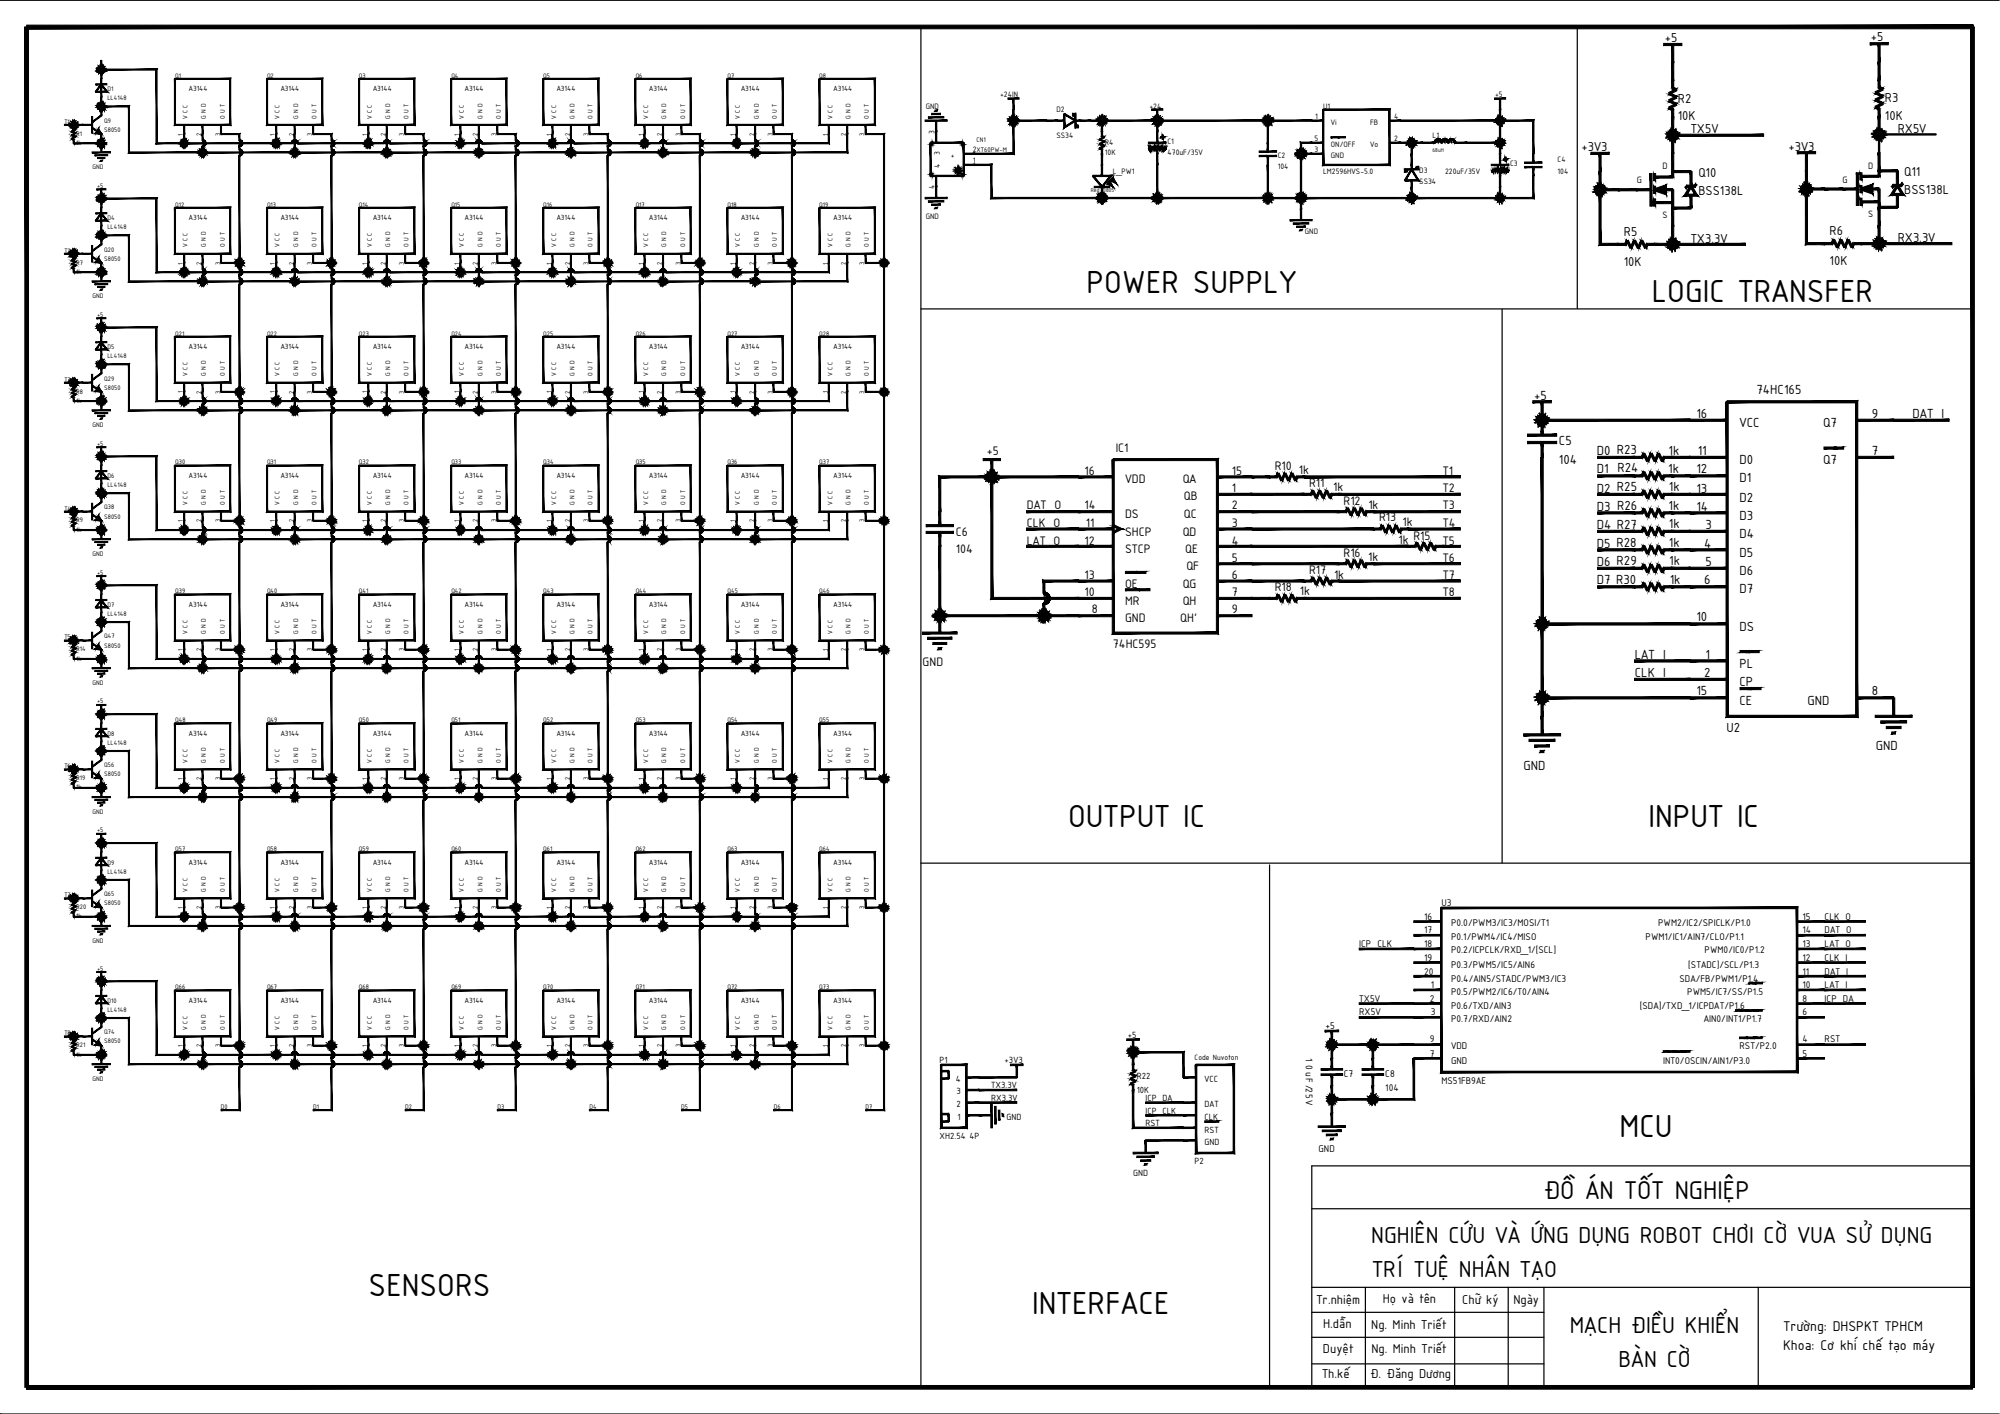
[picture p32: page 1]

ĐỒ ÁN TỐT NGHIỆP

NGHIÊN CỨU VÀ ỨNG DỤNG ROBOT CHƠI CỜ VUA SỬ DỤNG
TRÍ TUỆ NHÂN TẠO

Trường: DHSPKT TPHCM
Khoa: Cơ khí chế tạo máy
