dangdangduong2k2/Graduation_project/0.HardWare_Unit/0.PCB/0.chess board/GiaCong/dimension 2024-12-22 chessboard.PDF

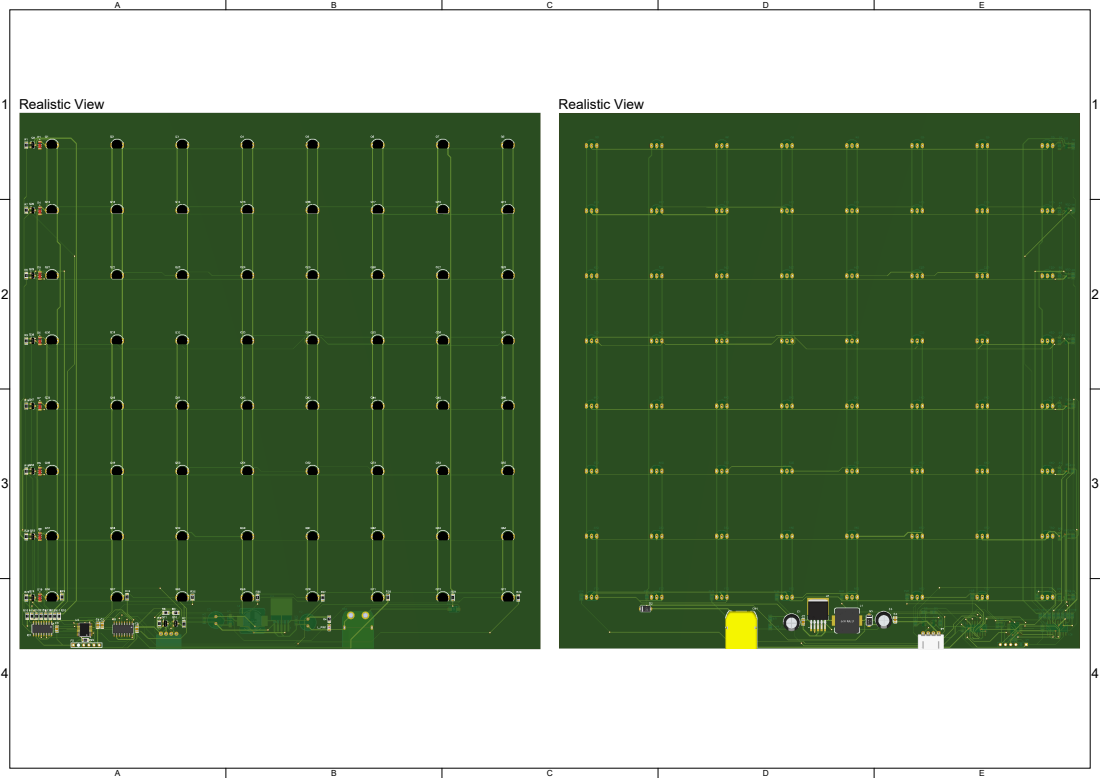
[picture p33: page 1]
