dangdangduong2k2/Graduation_project/0.HardWare_Unit/0.PCB/0.chess board/GiaCong/Local/3D_PDF 2024-12-22 chessboard.PDF

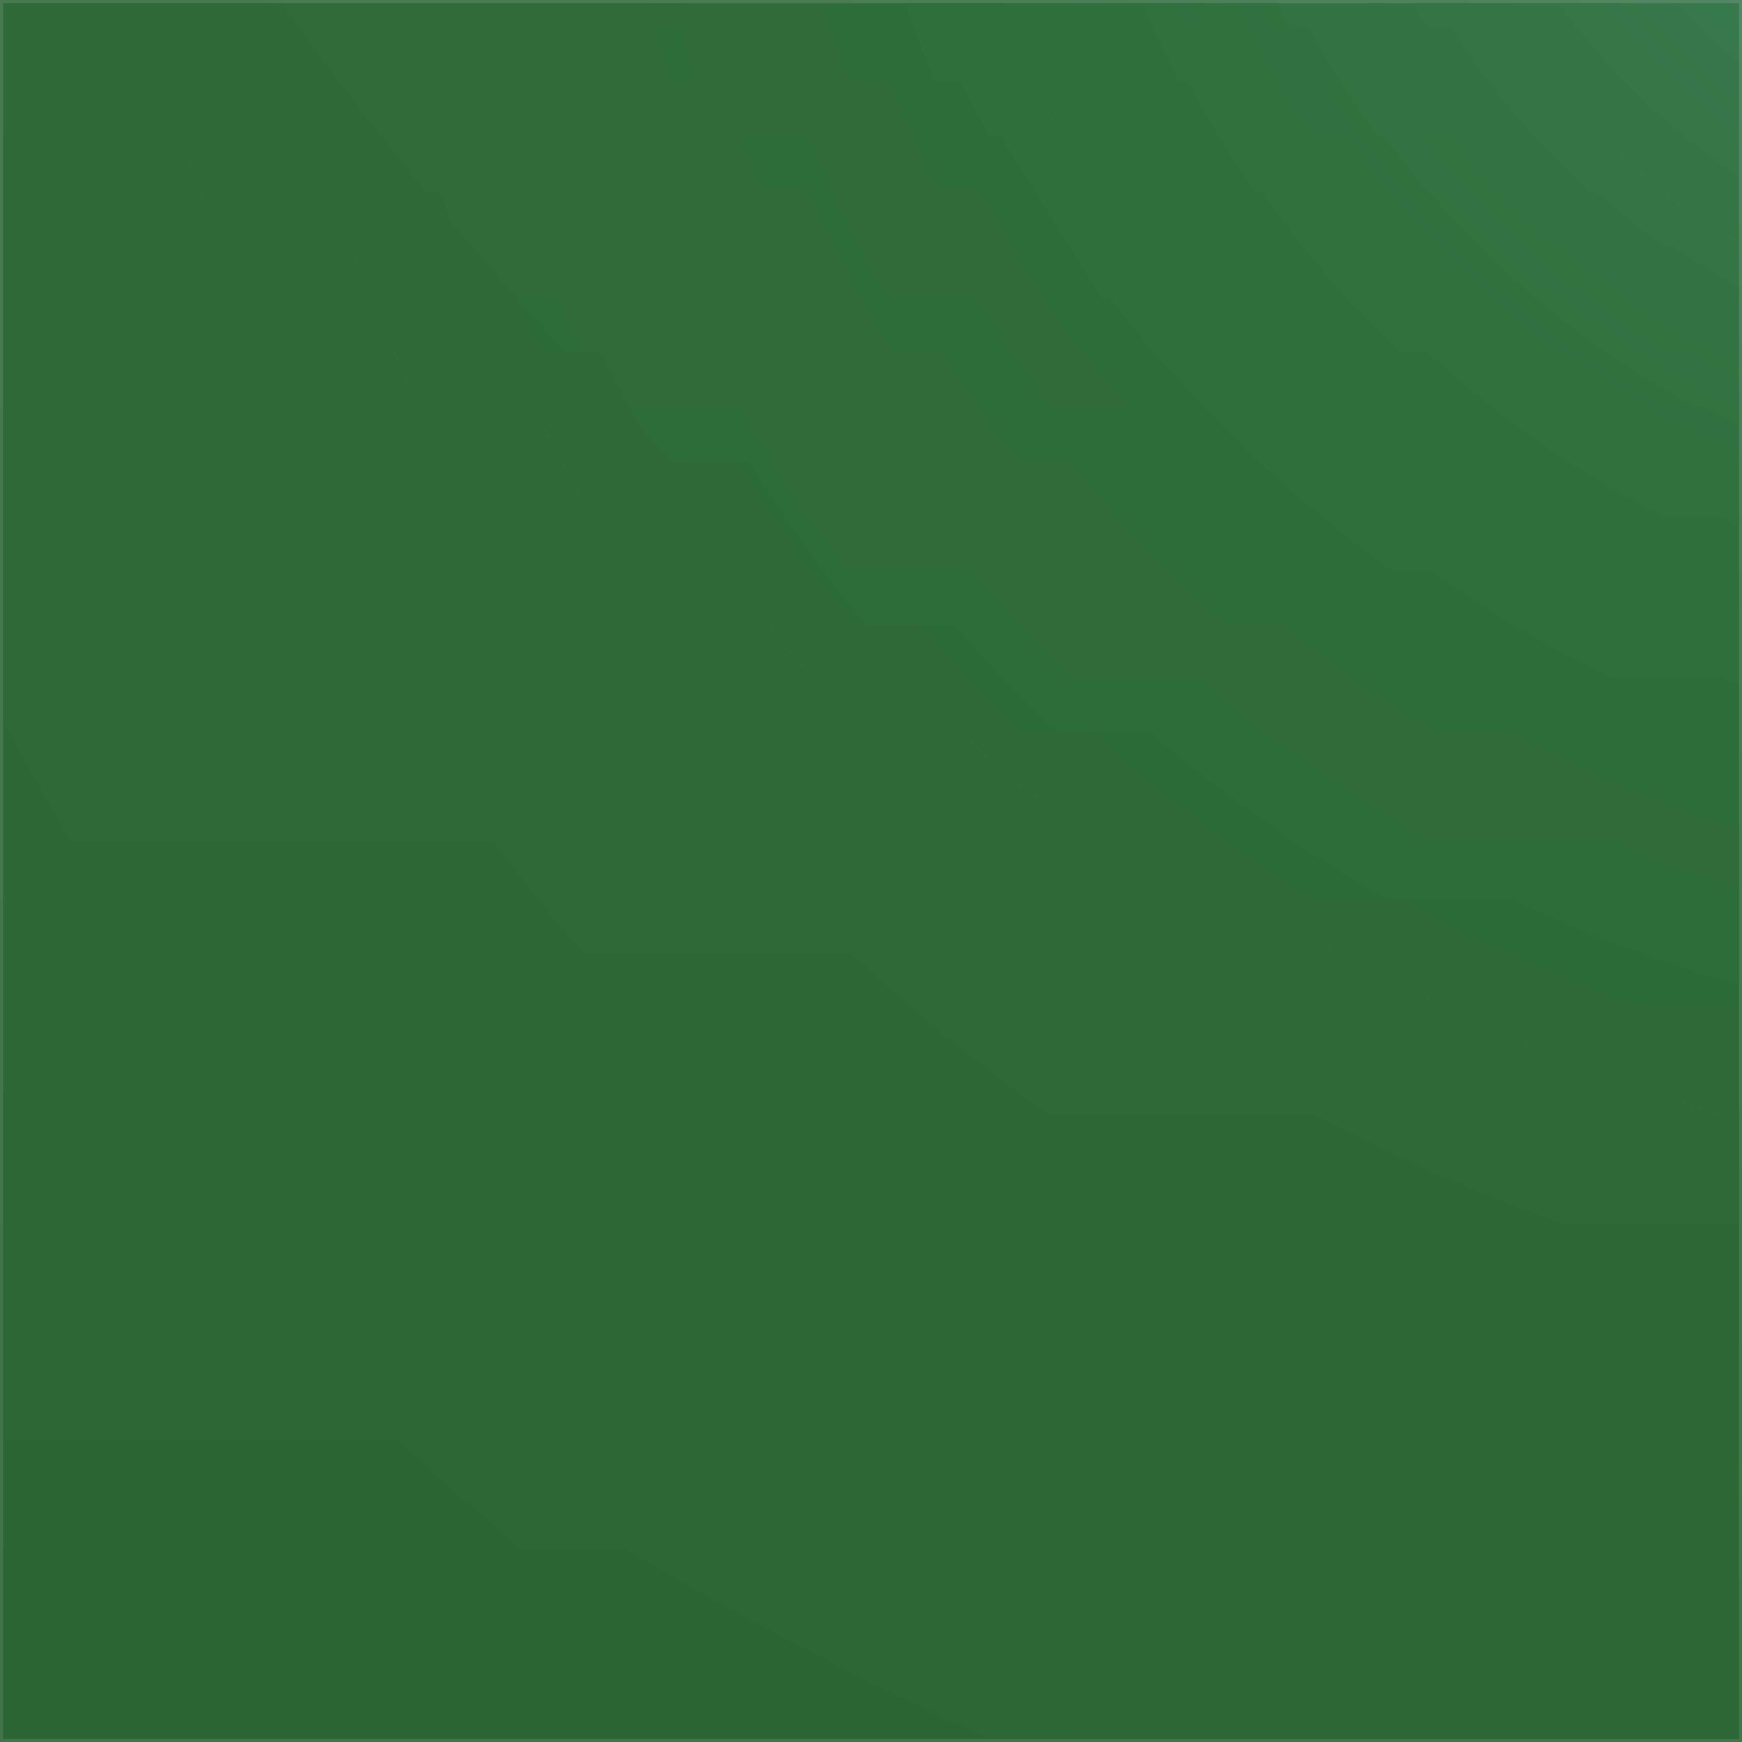
[picture p34: page 1]

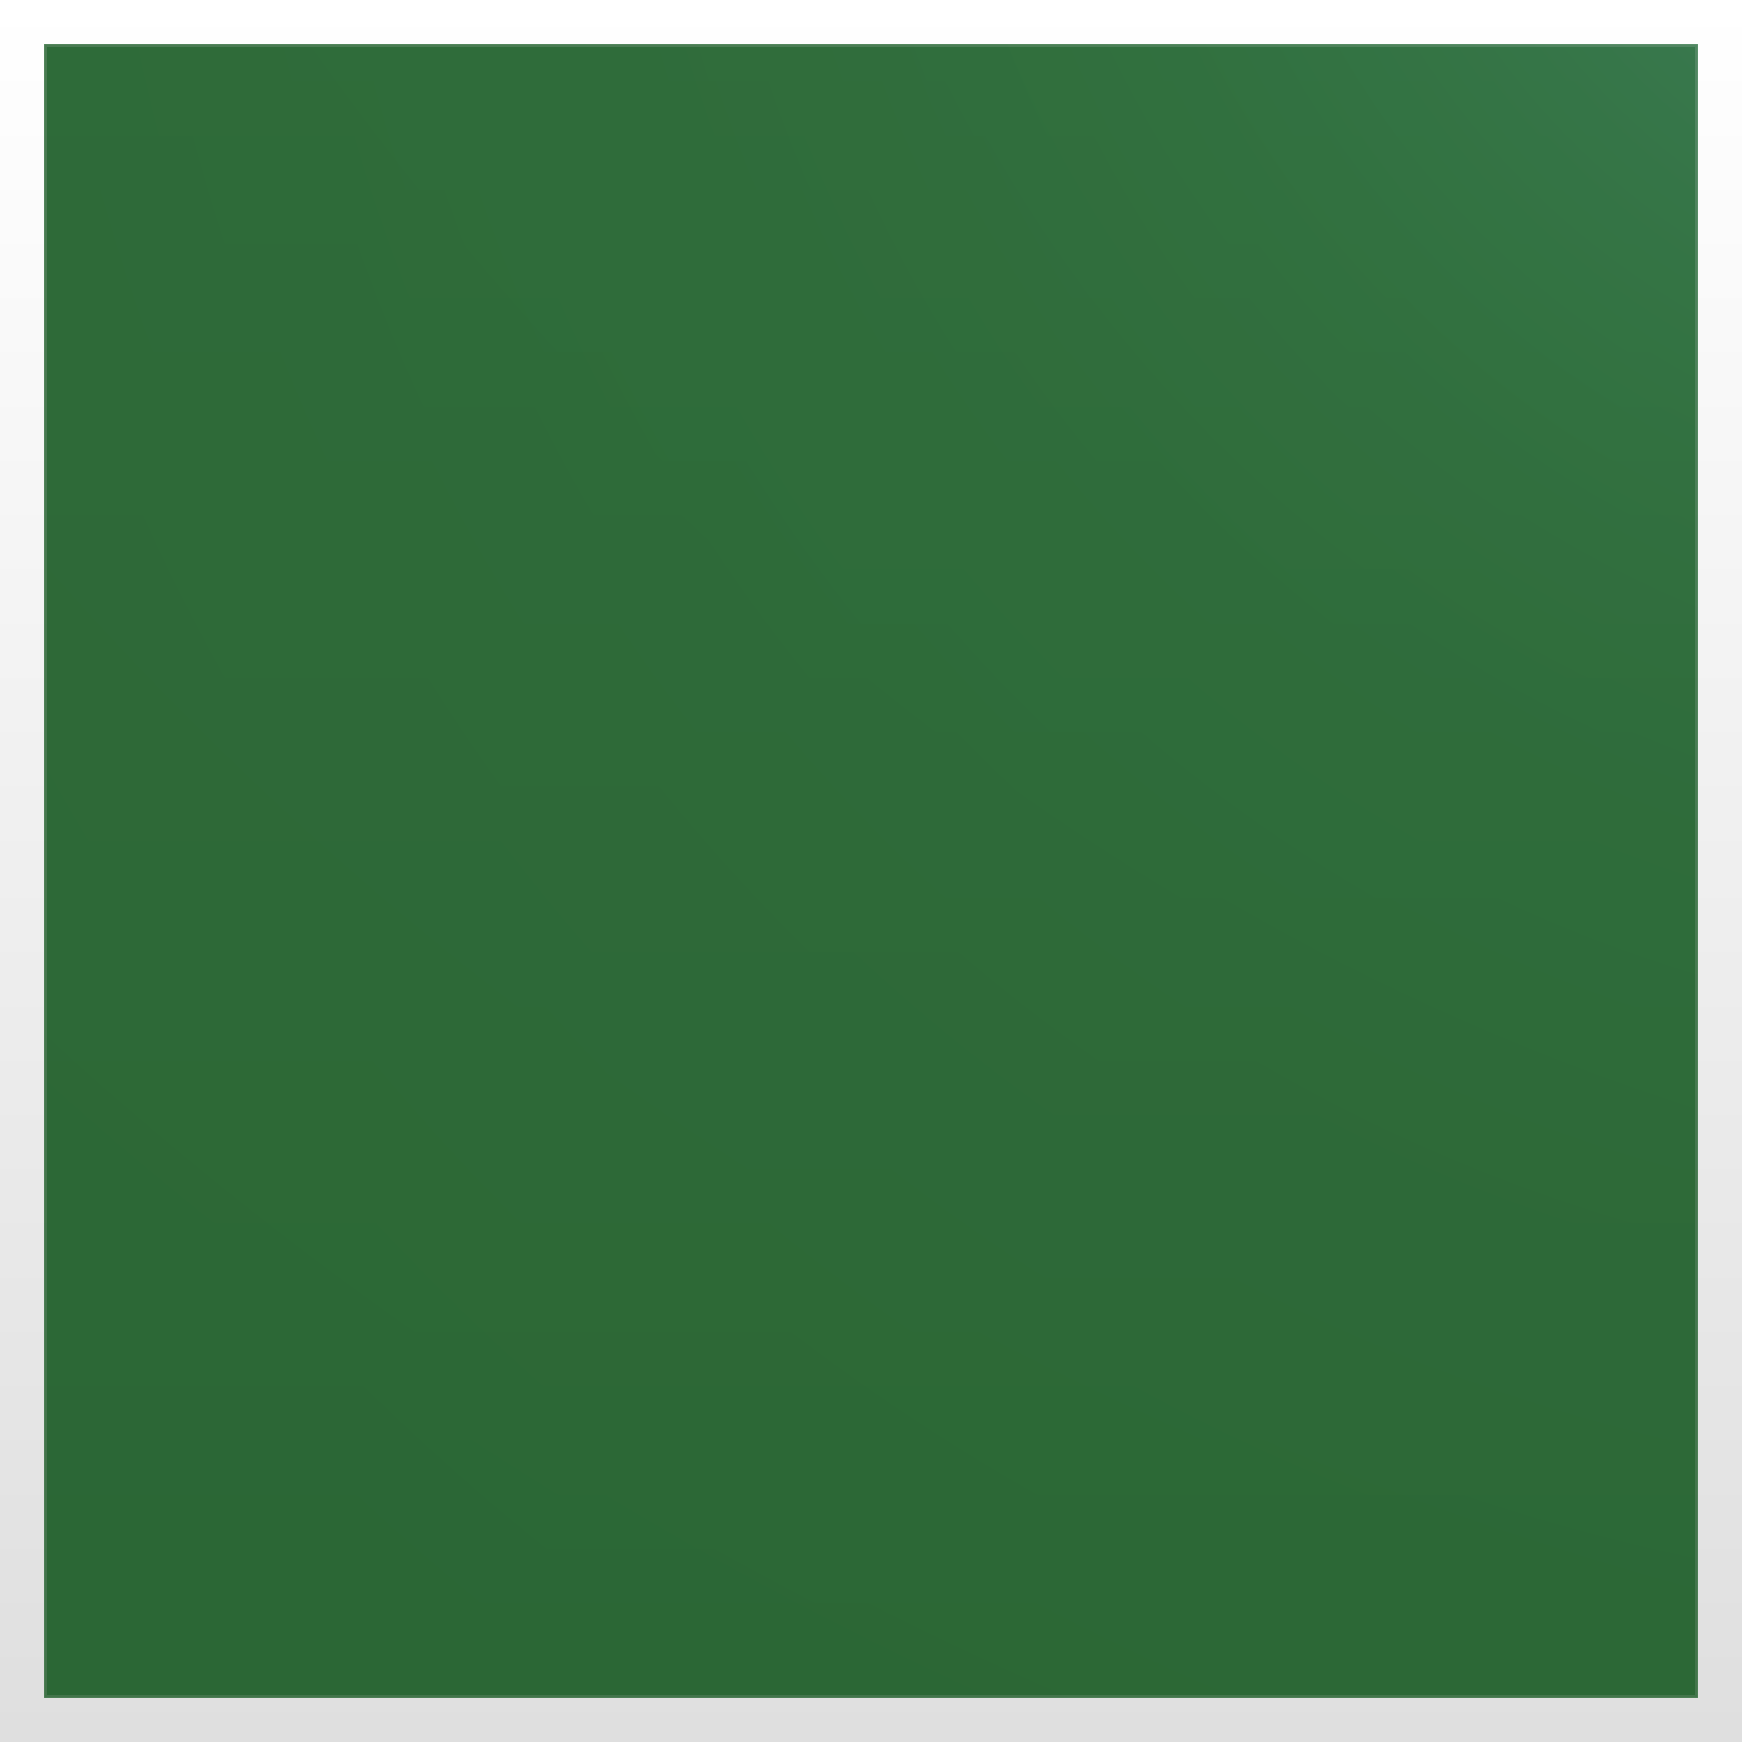
[picture p35: page 2]

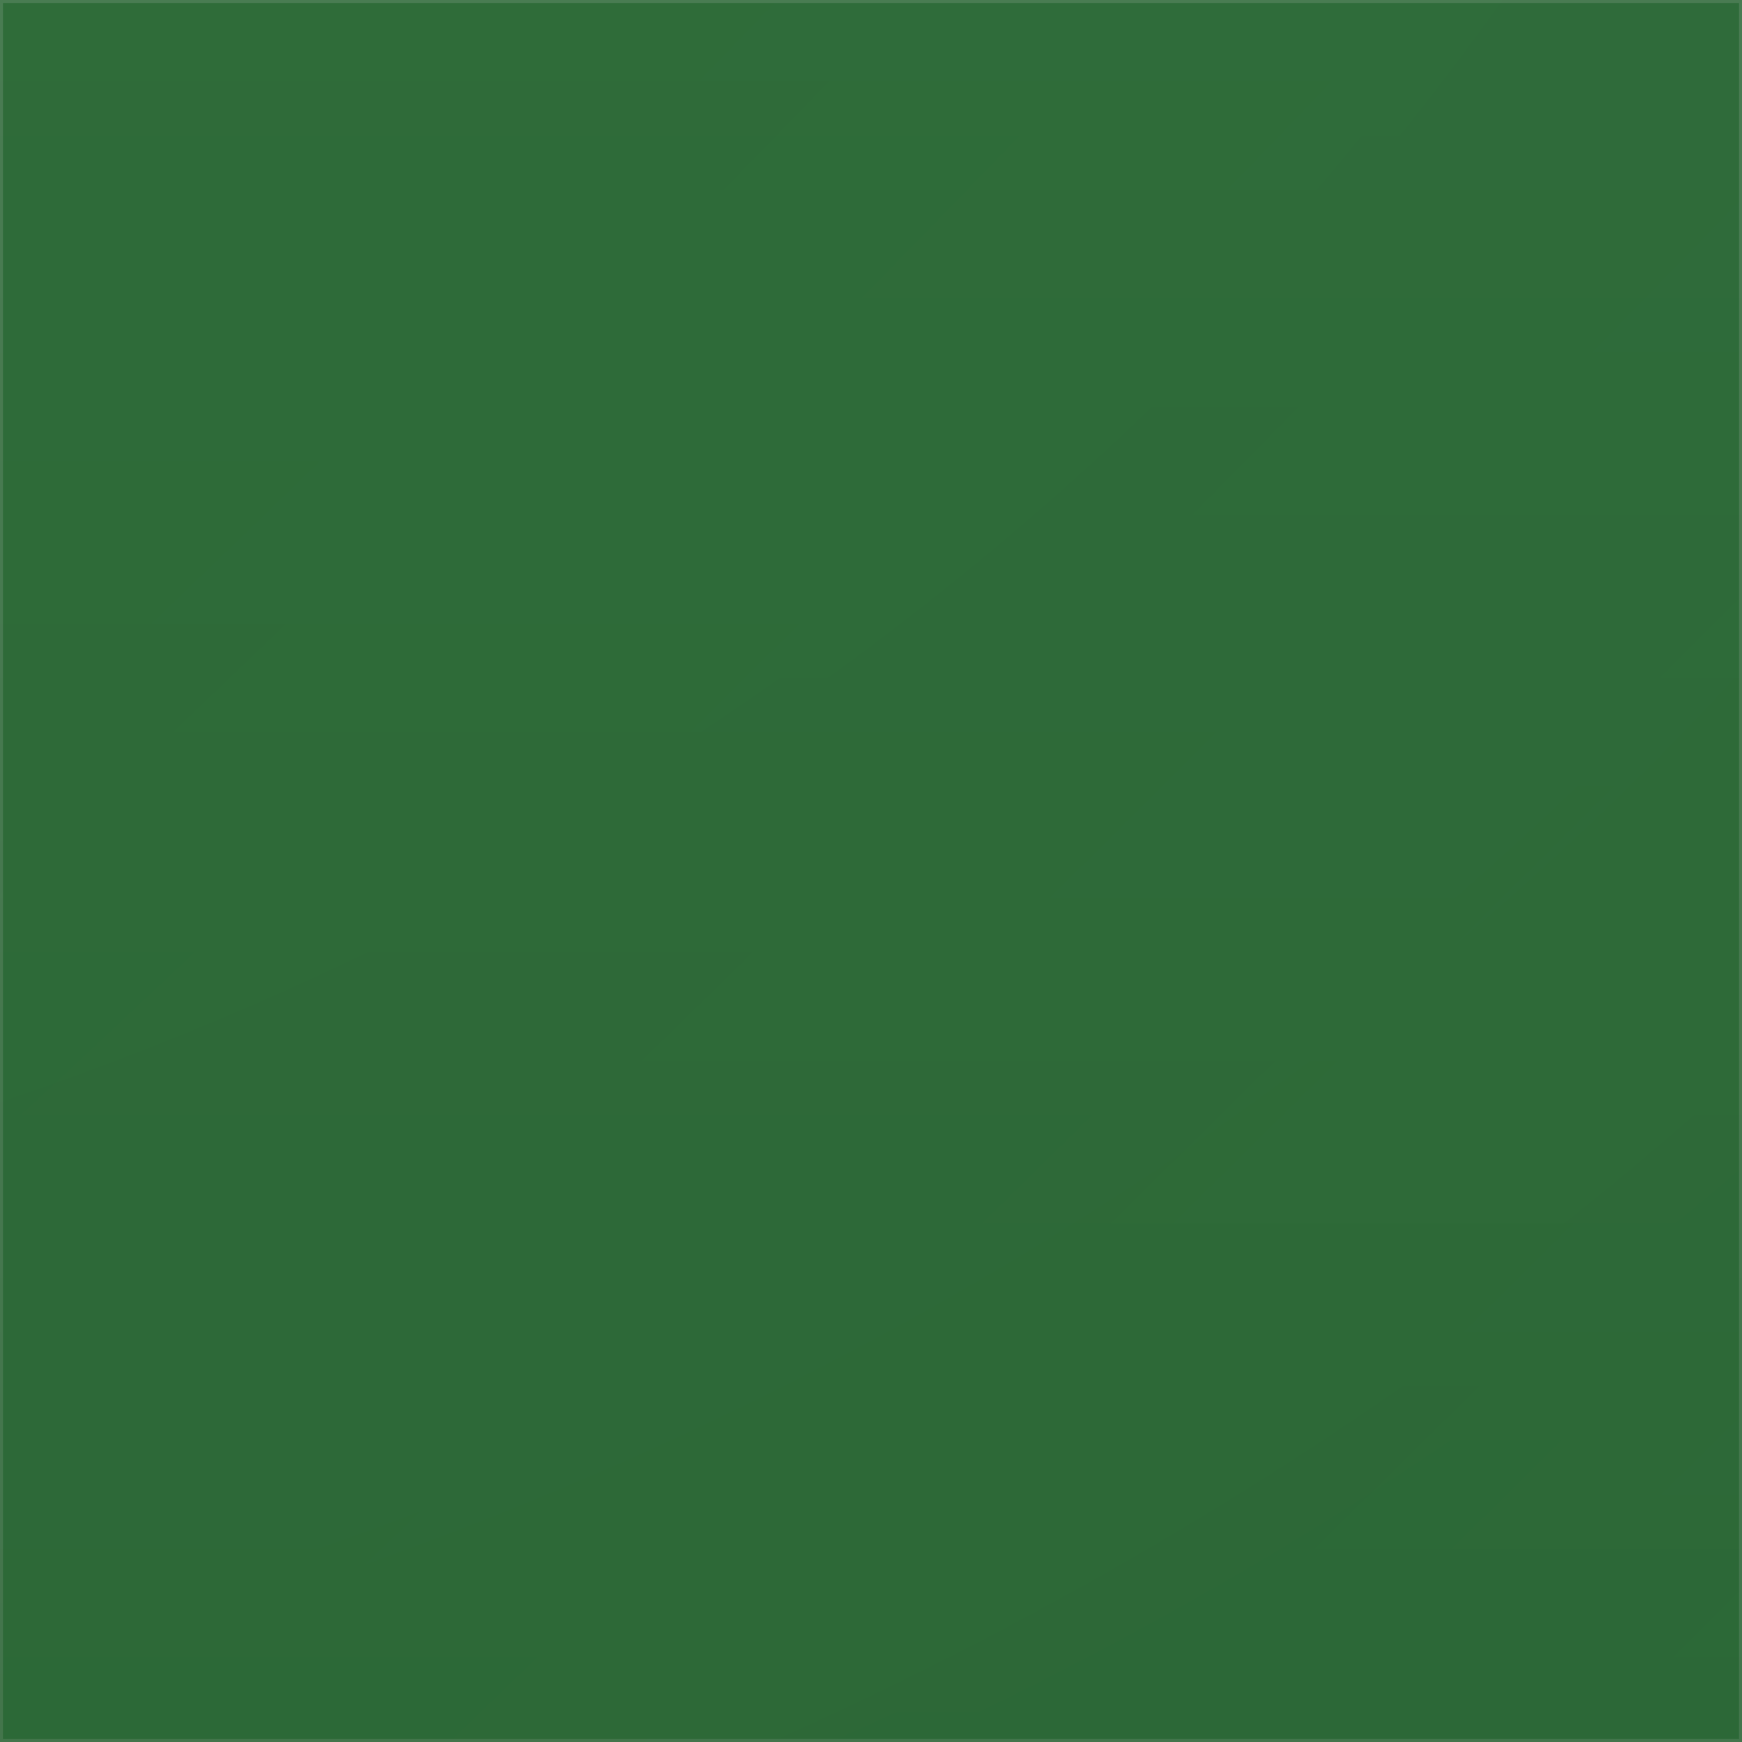
[picture p36: page 3]
