dangdangduong2k2/Graduation_project/0.HardWare_Unit/0.PCB/1.main/GiaCong/main/3d.PDF

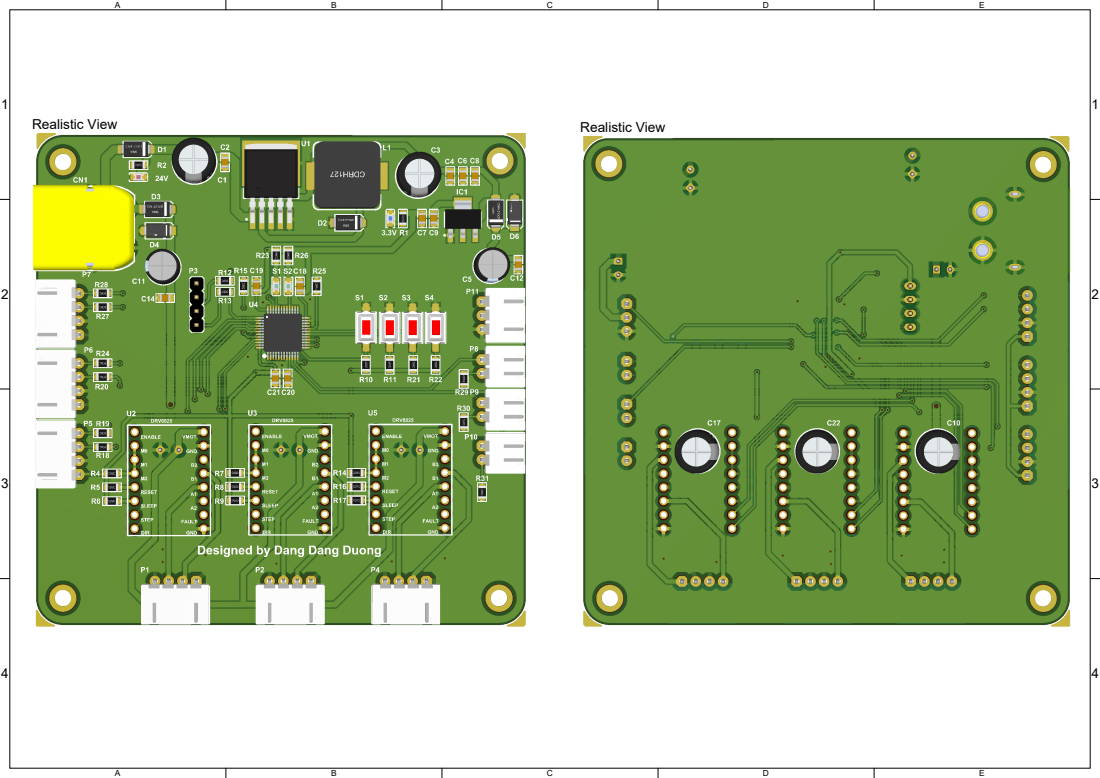
[picture p37: page 1]
