dangdangduong2k2/Graduation_project/(list of files, drawings)

Other design files:
0.HardWare_Unit/0.PCB/0.chess board/chessboard.PrjPCB
0.HardWare_Unit/0.PCB/0.chess board/panel 2x4.PcbDoc
0.HardWare_Unit/0.PCB/0.chess board/schematic.SchDoc
0.HardWare_Unit/0.PCB/1.main/gpr.PrjPCB
0.HardWare_Unit/0.PCB/1.main/panel 2x4.PcbDoc
0.HardWare_Unit/0.PCB/1.main/schematic.SchDoc
pcb/chess board/pcb.PcbDoc
