dangdangduong2k2/Graduation_project/0.HardWare_Unit/1.Code/Main_Robot/Main_Robot.ioc

Mcu.UserName=STM32F103C8Tx
PA0-WKUP.GPIO_Label=endz
PA0-WKUP.Signal=GPIO_Input
PA1.GPIO_Label=endx
PA1.Signal=GPIO_Input
PA10.Signal=USART1_RX
PA12.GPIO_Label=LED0
PA12.Signal=GPIO_Output
PA15.Signal=GPIO_Output
PA2.Signal=USART2_TX
PA3.Signal=USART2_RX
PA4.GPIO_Label=endy
PA4.Signal=GPIO_Input
PA6.Signal=S_TIM3_CH1
PA9.Signal=USART1_TX
PB0.GPIO_Label=key1
PB0.Signal=GPXTI0
PB1.GPIO_Label=key2
PB1.Signal=GPIO_Input
PB10.Signal=USART3_TX
PB11.Signal=USART3_RX
PB15.GPIO_Label=LED1
PB15.Signal=GPIO_Output
PB3.GPIO_Label=key3
PB3.Signal=GPIO_Input
PB4.Signal=GPIO_Output
PB5.Signal=GPIO_Output
PB6.Signal=GPIO_Output
PB8.Signal=GPIO_Output
PB9.Signal=GPIO_Output
