dangdangduong2k2/Graduation_project/0.HardWare_Unit/1.Code/Main_Robot/Core/Src/GPIO.c

#include "GPIO.h"

#define endz_Pin GPIO_PIN_0
#define endz_GPIO_Port GPIOA
#define endx_Pin GPIO_PIN_1
#define endx_GPIO_Port GPIOA
#define endy_Pin GPIO_PIN_4
#define endy_GPIO_Port GPIOA
#define key1_Pin GPIO_PIN_0
#define key1_GPIO_Port GPIOB
#define key2_Pin GPIO_PIN_1
#define key2_GPIO_Port GPIOB
#define LED1_Pin GPIO_PIN_15
#define LED1_GPIO_Port GPIOB
#define LED0_Pin GPIO_PIN_12
#define LED0_GPIO_Port GPIOA
#define key3_Pin GPIO_PIN_3
#define key3_GPIO_Port GPIOB

void MX_GPIO_Init(void)
{
  GPIO_InitTypeDef GPIO_InitStruct = {0};

  /* GPIO Ports Clock Enable */
  __HAL_RCC_GPIOA_CLK_ENABLE();
  __HAL_RCC_GPIOB_CLK_ENABLE();

  /*Configure GPIO pin Output Level */
  HAL_GPIO_WritePin(GPIOB, GPIO_PIN_15|GPIO_PIN_4|GPIO_PIN_5|GPIO_PIN_6
                          |GPIO_PIN_8|GPIO_PIN_9, GPIO_PIN_RESET);

  /*Configure GPIO pin Output Level */
  HAL_GPIO_WritePin(GPIOA, GPIO_PIN_12|GPIO_PIN_15, GPIO_PIN_RESET);

  /*Configure GPIO pins : PA0 PA1 PA4 */
  GPIO_InitStruct.Pin = GPIO_PIN_0|GPIO_PIN_1|GPIO_PIN_4;
  GPIO_InitStruct.Mode = GPIO_MODE_INPUT;
  GPIO_InitStruct.Pull = GPIO_NOPULL;
  HAL_GPIO_Init(GPIOA, &GPIO_InitStruct);

  /*Configure GPIO pin : PB0 */
  GPIO_InitStruct.Pin = GPIO_PIN_0;
  GPIO_InitStruct.Mode = GPIO_MODE_IT_RISING;
  GPIO_InitStruct.Pull = GPIO_NOPULL;
  HAL_GPIO_Init(GPIOB, &GPIO_InitStruct);

  /*Configure GPIO pins : PB1 PB3 */
  GPIO_InitStruct.Pin = GPIO_PIN_1|GPIO_PIN_3;
  GPIO_InitStruct.Mode = GPIO_MODE_INPUT;
  GPIO_InitStruct.Pull = GPIO_NOPULL;
  HAL_GPIO_Init(GPIOB, &GPIO_InitStruct);

  /*Configure GPIO pins : PB15 PB4 PB5 PB6
                           PB8 PB9 */
  GPIO_InitStruct.Pin = GPIO_PIN_15|GPIO_PIN_4|GPIO_PIN_5|GPIO_PIN_6
                          |GPIO_PIN_8|GPIO_PIN_9;
  GPIO_InitStruct.Mode = GPIO_MODE_OUTPUT_PP;
  GPIO_InitStruct.Pull = GPIO_NOPULL;
  GPIO_InitStruct.Speed = GPIO_SPEED_FREQ_LOW;
  HAL_GPIO_Init(GPIOB, &GPIO_InitStruct);

  /*Configure GPIO pins : PA12 PA15 */
  GPIO_InitStruct.Pin = GPIO_PIN_12|GPIO_PIN_15;
  GPIO_InitStruct.Mode = GPIO_MODE_OUTPUT_PP;
  GPIO_InitStruct.Pull = GPIO_NOPULL;
  GPIO_InitStruct.Speed = GPIO_SPEED_FREQ_LOW;
  HAL_GPIO_Init(GPIOA, &GPIO_InitStruct);

}
