dangdangduong2k2/Graduation_project/0.HardWare_Unit/1.Code/Main_Robot/Core/Inc/main.h

#ifndef __MAIN_H
#define __MAIN_H

#ifdef __cplusplus
extern "C" {
#endif

#include "stm32f1xx_hal.h"

#include "GPIO.h"
#include "Clock.h"
#include "Timer.h"
void HAL_TIM_MspPostInit(TIM_HandleTypeDef *htim);

void Error_Handler(void);



#ifdef __cplusplus
}
#endif

#endif 
