dangdangduong2k2/Graduation_project/0.HardWare_Unit/1.Code/Main_Robot/Core/Inc/Clock.h

#ifndef __CLOCK_H
#define __CLOCK_H

#ifdef __cplusplus
extern "C" {
#endif

/* Includes ------------------------------------------------------------------*/
#include "stm32f1xx_hal.h"


void SystemClock_Config(void);
#ifdef __cplusplus
}
#endif

#endif /* __MAIN_H */
