dangdangduong2k2/Graduation_project/0.HardWare_Unit/1.Code/Main_Robot/Core/Inc/GPIO.h

#ifndef __GPIO_H
#define __GPIO_H

#ifdef __cplusplus
extern "C" {
#endif

/* Includes ------------------------------------------------------------------*/
#include "stm32f1xx_hal.h"

void MX_GPIO_Init(void);

#ifdef __cplusplus
}
#endif

#endif /* __MAIN_H */
