dangdangduong2k2/Graduation_project/0.HardWare_Unit/1.Code/Main_Robot/Core/Inc/Timer.h

#ifndef __TIMER_H
#define __TIMER_H

#ifdef __cplusplus
extern "C" {
#endif

/* Includes ------------------------------------------------------------------*/
#include "stm32f1xx_hal.h"

void MX_TIM1_Init(void);
void MX_TIM2_Init(void);
void MX_TIM3_Init(void);
void MX_TIM4_Init(void);
extern TIM_HandleTypeDef htim1;
extern TIM_HandleTypeDef htim2;
extern TIM_HandleTypeDef htim3;
extern TIM_HandleTypeDef htim4;
#ifdef __cplusplus
}
#endif

#endif /* __MAIN_H */
