dangdangduong2k2/Graduation_project/(commit log)

2024-12-17 remake folder
    [2024-12-17 BOM gpr.xlsx, 623zz Bearing Cap.stl, Pen Holder.stl, RA2_ClawBase.stl, RA2_Claw_Frontbar.stl, RA2_Claw_Gripper.stl, RA2_Claw_LeftGear.stl, RA2_Claw_Main.stl]
2025-01-12 add banve, code robot, code banco
    [2024-12-17 BOM gpr.xlsx, 2024-12-24 BOM gpr.xlsx, 623zz Bearing Cap.stl, ARM_BOTTOM_[V10.stl, ARM_HUB_[V11.stl, ARM_TOP_[V9.stl, BASEPLATE_[V10.stl, CABLES_CAP_[V10.stl]
