dangdangduong2k2/Graduation_project/(notices)

Notices in the files:
0.HardWare_Unit/1.Code/clock/Core/Src/main.c:
Copyright (c) 2025 STMicroelectronics.
All rights reserved.
This software is licensed under terms that can be found in the LICENSE file
